gili-yankovitch/joyfon/images/hero-joyfon.png

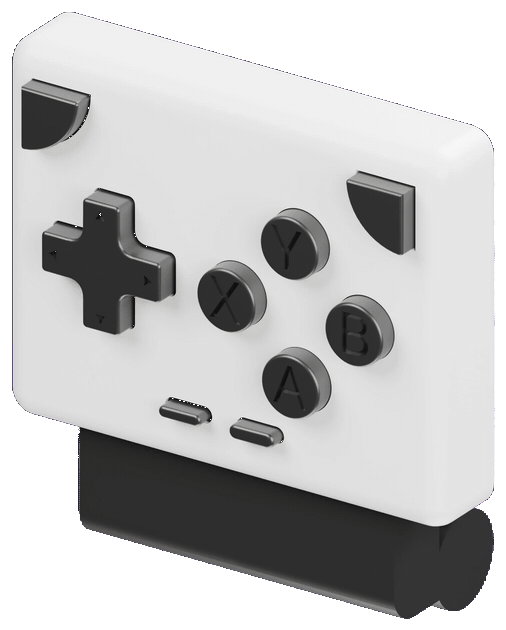
images/hero-joyfon.png
