gili-yankovitch/joyfon/images/assembly/inventory-labeled-preview.jpg

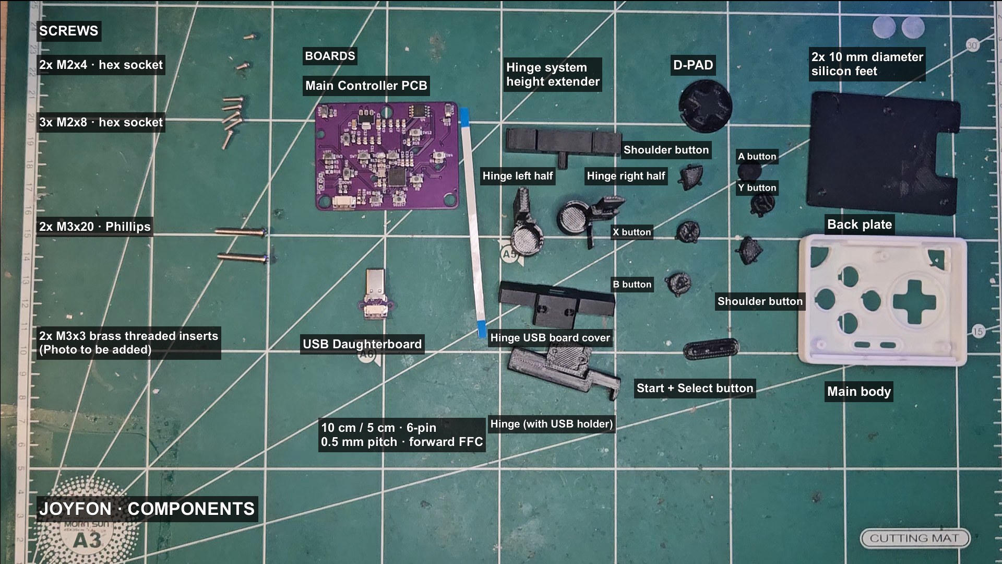
images/assembly/inventory-labeled-preview.jpg
