gili-yankovitch/joyfon/stl/PhoneControllerCaseV0.3 - ControllerBody.stl

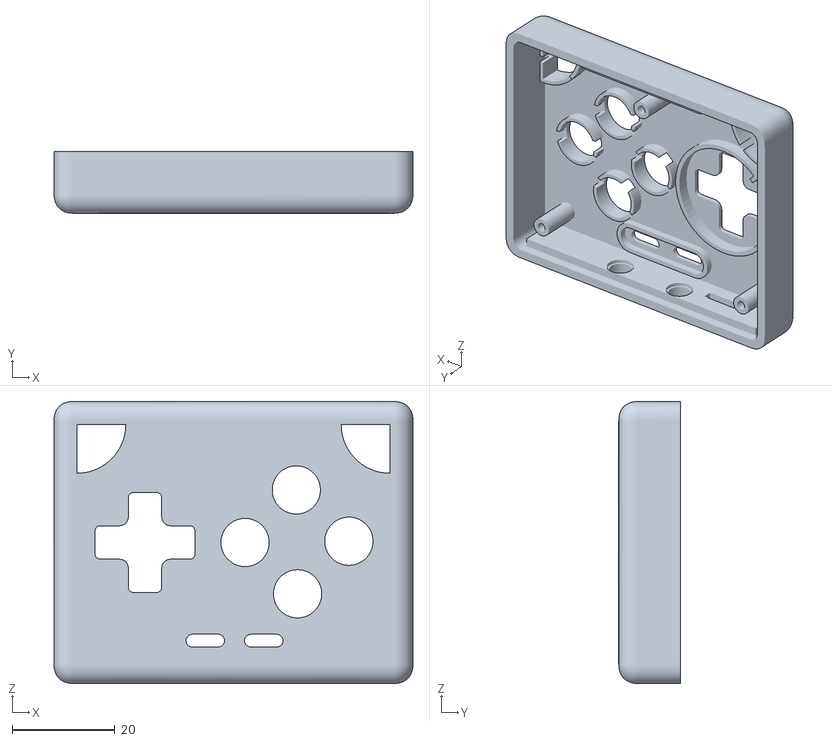
[picture p8: CAD file, 2026-10-31]
stl/PhoneControllerCaseV0.3 - ControllerBody.stl
70.0 x 12.0 x 55.0
