gili-yankovitch/joyfon/stl/PhoneControllerCaseV0.3 - BtnY.stl

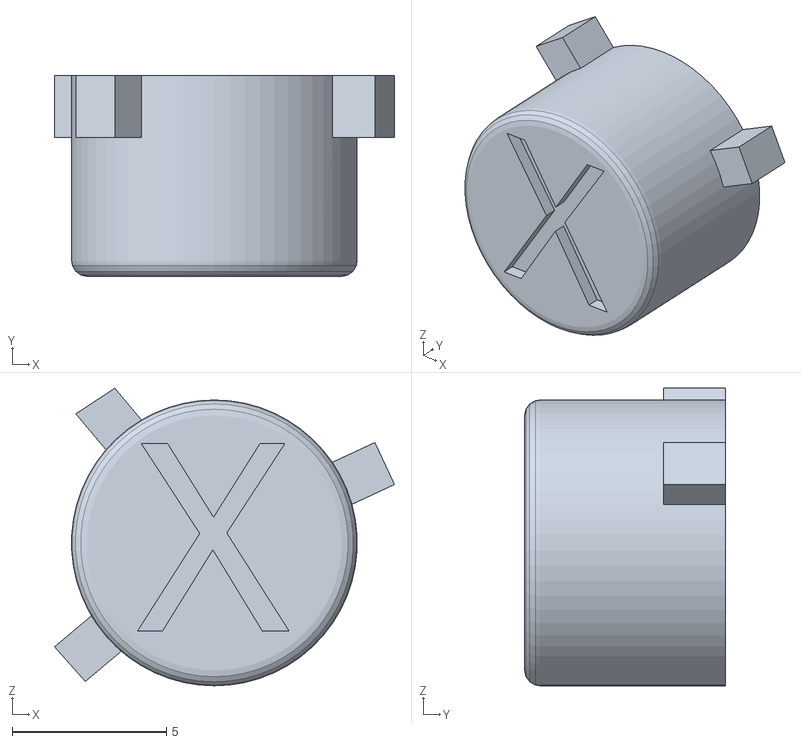
[picture p9: CAD file, 2026-10-31]
stl/PhoneControllerCaseV0.3 - BtnY.stl
11.0 x 6.50 x 9.63
