gili-yankovitch/joyfon/stl/PhoneControllerCaseV0.3 - BtnSL.stl

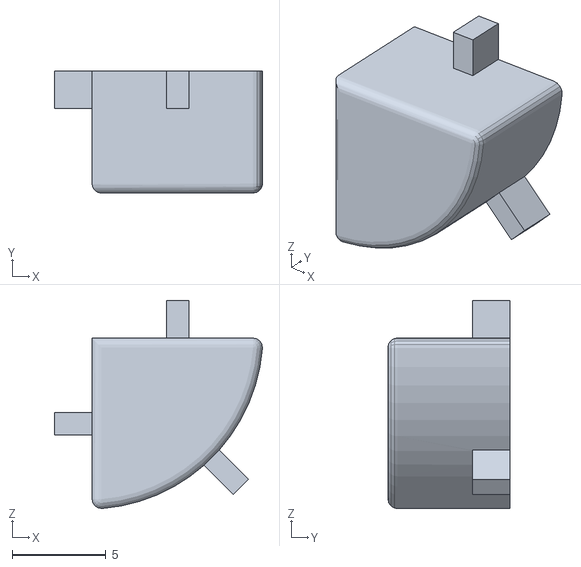
[picture p10: CAD file, 2026-10-31]
stl/PhoneControllerCaseV0.3 - BtnSL.stl
11.1 x 6.50 x 11.1
