gili-yankovitch/joyfon/stl/PhoneControllerCaseV0.3 - BtnX.stl

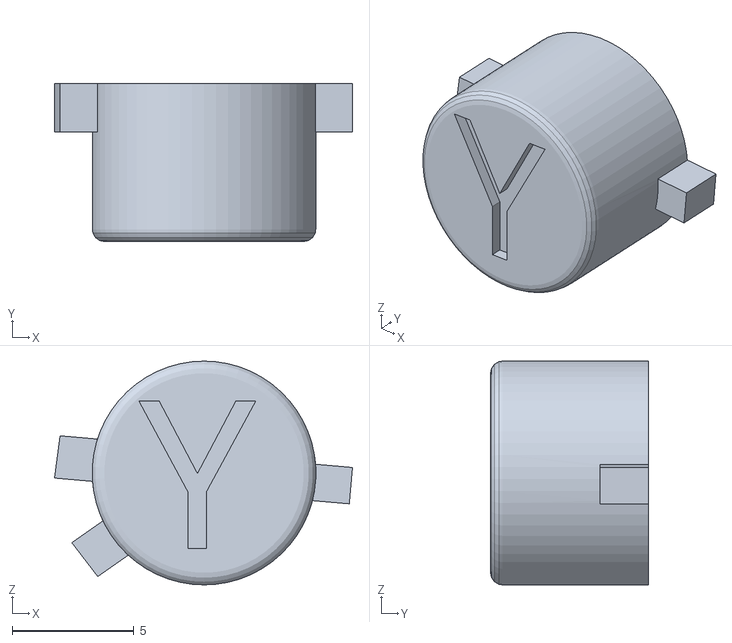
[picture p11: CAD file, 2026-10-31]
stl/PhoneControllerCaseV0.3 - BtnX.stl
12.3 x 6.50 x 9.20
