gili-yankovitch/joyfon/stl/PhoneControllerCaseV0.3 - BackPlate.stl

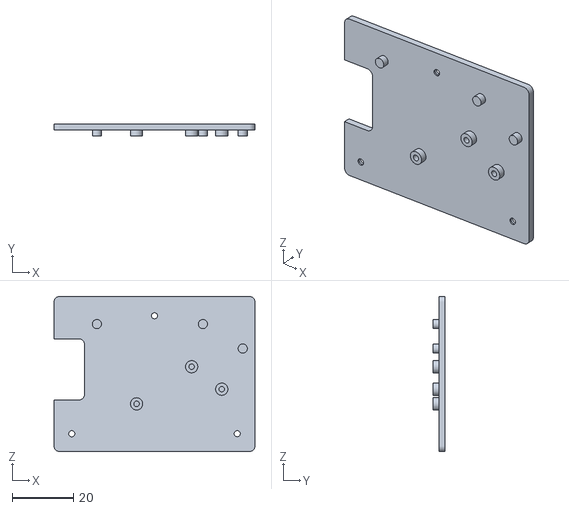
[picture p12: CAD file, 2026-10-31]
stl/PhoneControllerCaseV0.3 - BackPlate.stl
65.6 x 4.00 x 50.6
