gili-yankovitch/joyfon/stl/PhoneControllerCaseV0.3 - HingeHousingPart1-Ext.stl

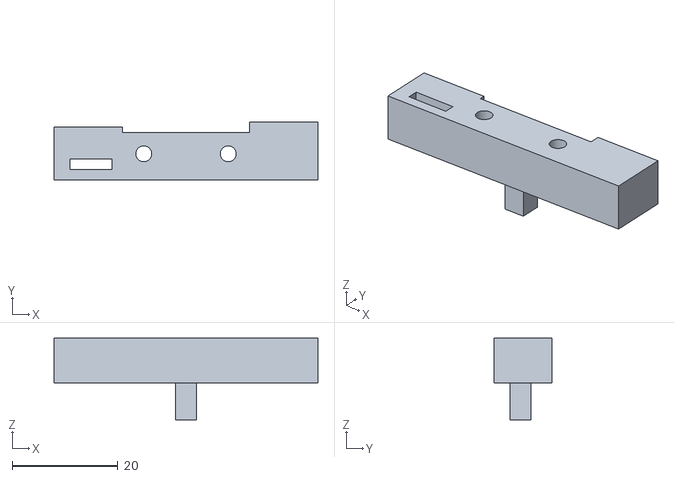
[picture p13: CAD file, 2026-10-31]
stl/PhoneControllerCaseV0.3 - HingeHousingPart1-Ext.stl
50.0 x 10.9 x 15.5
