gili-yankovitch/joyfon/stl/PhoneControllerCaseV0.3 - BtnB.stl

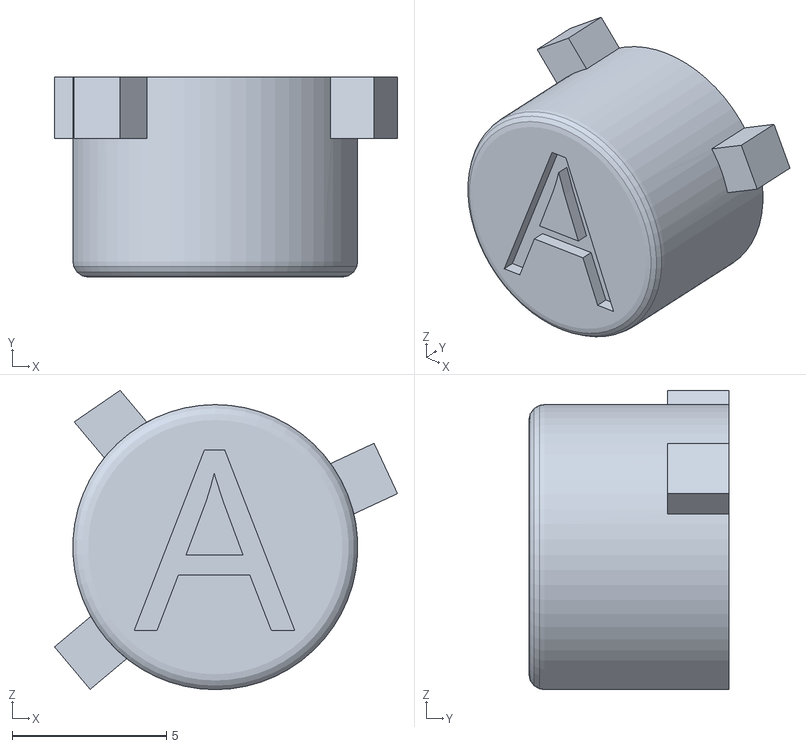
[picture p14: CAD file, 2026-10-31]
stl/PhoneControllerCaseV0.3 - BtnB.stl
11.1 x 6.50 x 9.71
