gili-yankovitch/joyfon/stl/PhoneControllerCaseV0.3 - Hinge USB2.stl

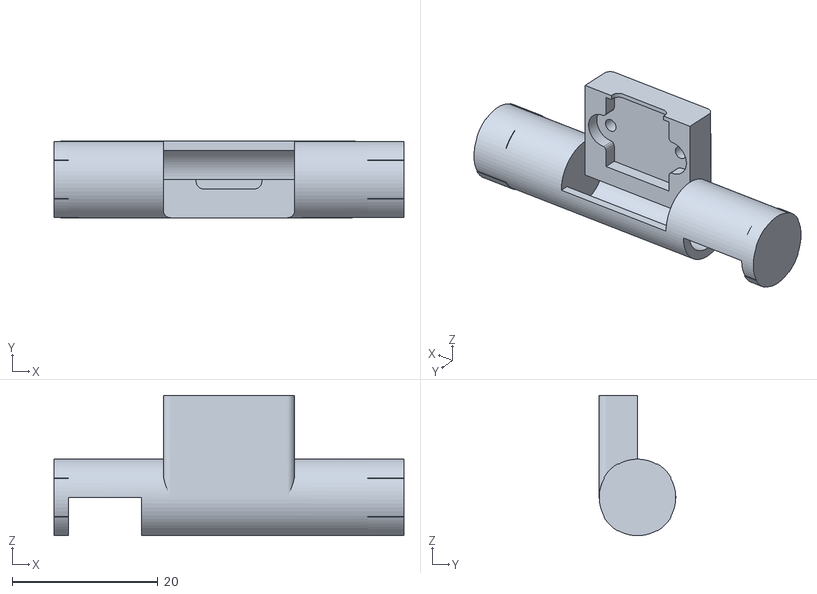
[picture p15: CAD file, 2026-10-31]
stl/PhoneControllerCaseV0.3 - Hinge USB2.stl
48.0 x 10.5 x 19.2
