gili-yankovitch/joyfon/stl/PhoneControllerCaseV0.3 - USB2 Cover.stl

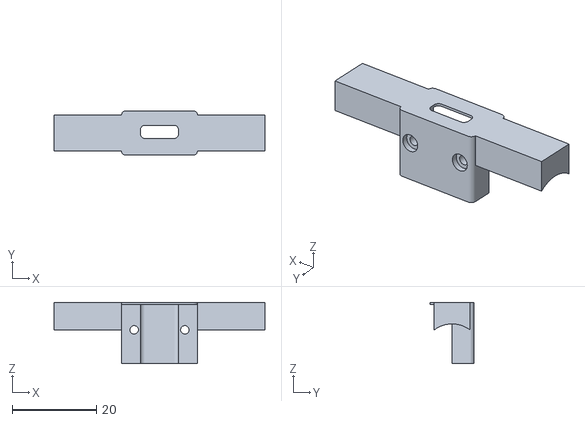
[picture p16: CAD file, 2026-10-31]
stl/PhoneControllerCaseV0.3 - USB2 Cover.stl
50.0 x 10.5 x 14.5
