gili-yankovitch/joyfon/stl/PhoneControllerCaseV0.3 - StartSelectBtns.stl

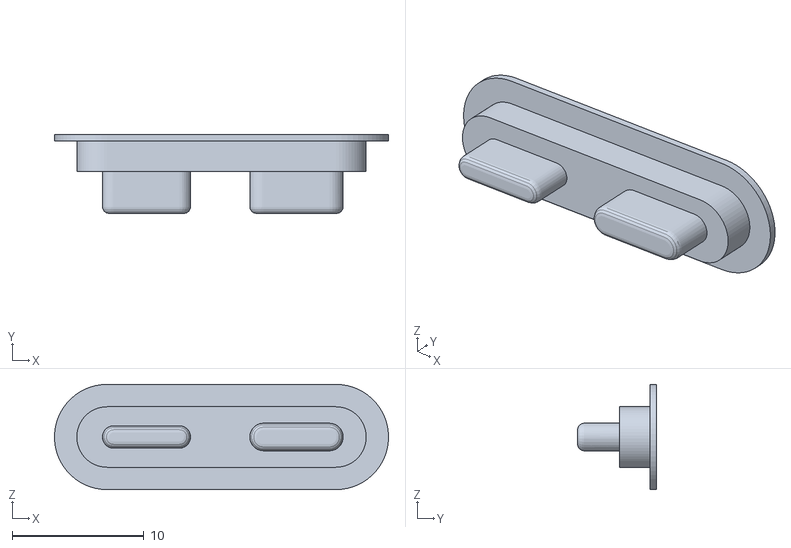
[picture p17: CAD file, 2026-10-31]
stl/PhoneControllerCaseV0.3 - StartSelectBtns.stl
25.4 x 6.00 x 8.00
