gili-yankovitch/joyfon/stl/PhoneControllerCaseV0.3 - HingeHousingPart1.stl

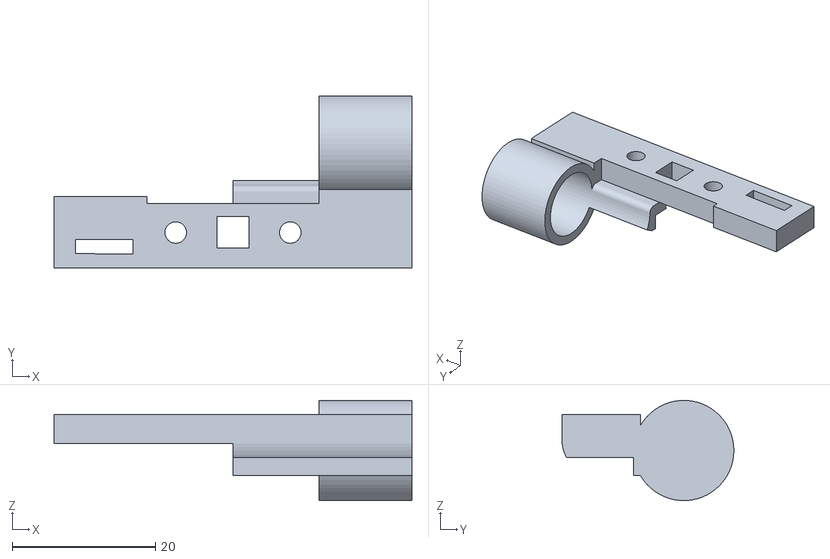
[picture p18: CAD file, 2026-10-31]
stl/PhoneControllerCaseV0.3 - HingeHousingPart1.stl
50.0 x 24.0 x 14.0
