gili-yankovitch/joyfon/stl/PhoneControllerCaseV0.3 - USB2.stl

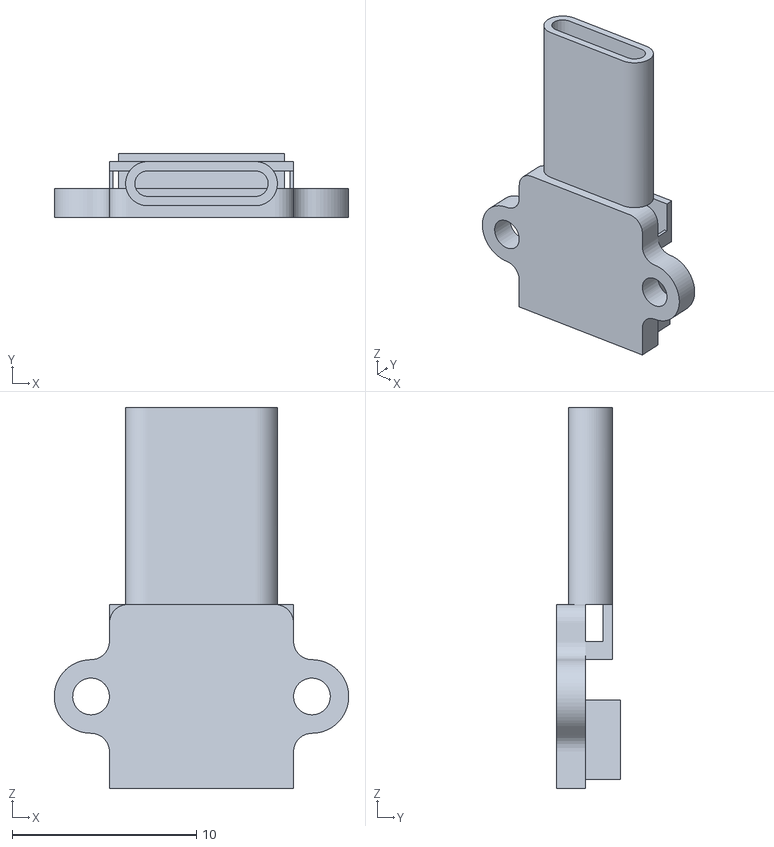
[picture p19: CAD file, 2026-10-31]
stl/PhoneControllerCaseV0.3 - USB2.stl
16.0 x 3.50 x 20.7
