gili-yankovitch/joyfon/stl/PhoneControllerCaseV0.3 - HingeHousingPart2.stl

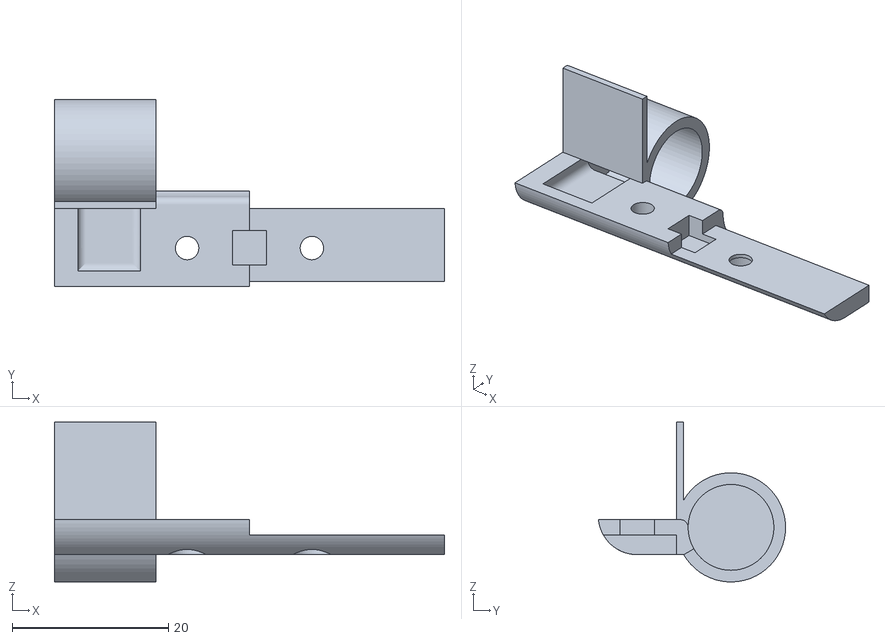
[picture p20: CAD file, 2026-10-31]
stl/PhoneControllerCaseV0.3 - HingeHousingPart2.stl
50.0 x 24.0 x 20.5
