gili-yankovitch/joyfon/stl/PhoneControllerCaseV0.3 - DPad.stl

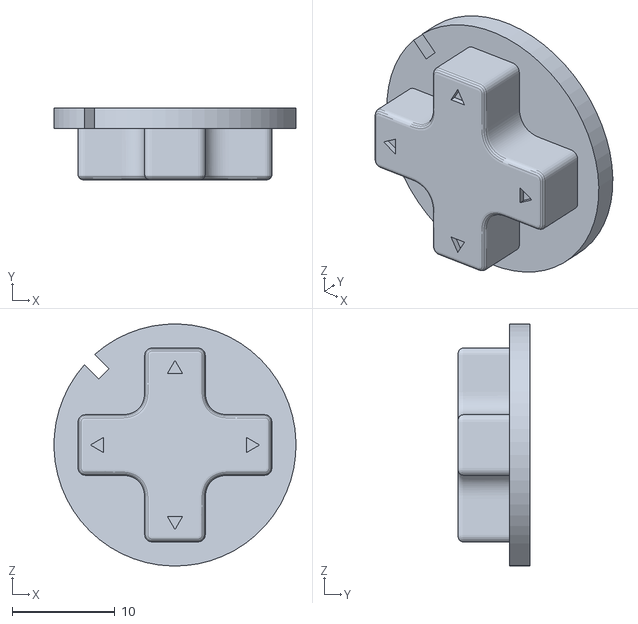
[picture p21: CAD file, 2026-10-31]
stl/PhoneControllerCaseV0.3 - DPad.stl
23.6 x 7.00 x 23.6
