gili-yankovitch/joyfon/stl/PhoneControllerCaseV0.3 - BtnA.stl

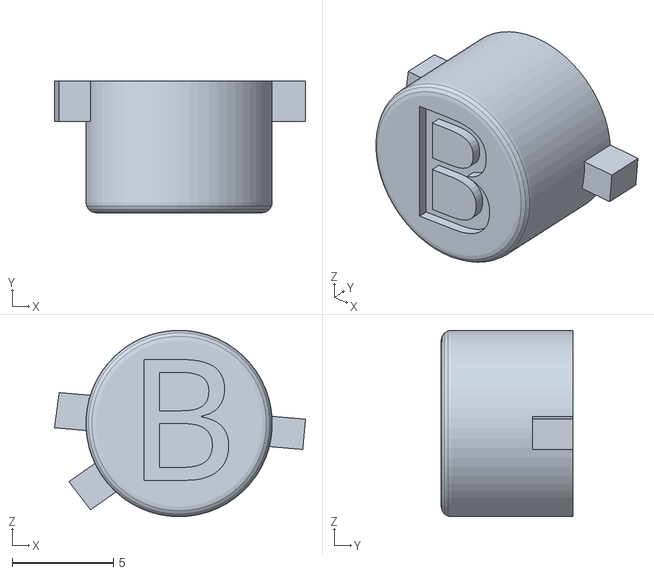
[picture p22: CAD file, 2026-10-31]
stl/PhoneControllerCaseV0.3 - BtnA.stl
12.4 x 6.50 x 9.20
