gili-yankovitch/joyfon/(list of files, cad)

Other CAD files:
stl/PhoneControllerCaseV0.3 - BtnSR.stl
