gili-yankovitch/joyfon/assembly.html

JOYFON ⚡ Flash Source ↗ (https://github.com/gili-yankovitch/joyfon)

Build your JoyFon · 12 steps

# Assembly guide

From the USB Daughterboard to the final button check. Follow the photos in order, with the correct fasteners and a check at every stage.

Start assembling ↓

Before you begin

## Parts on the table.

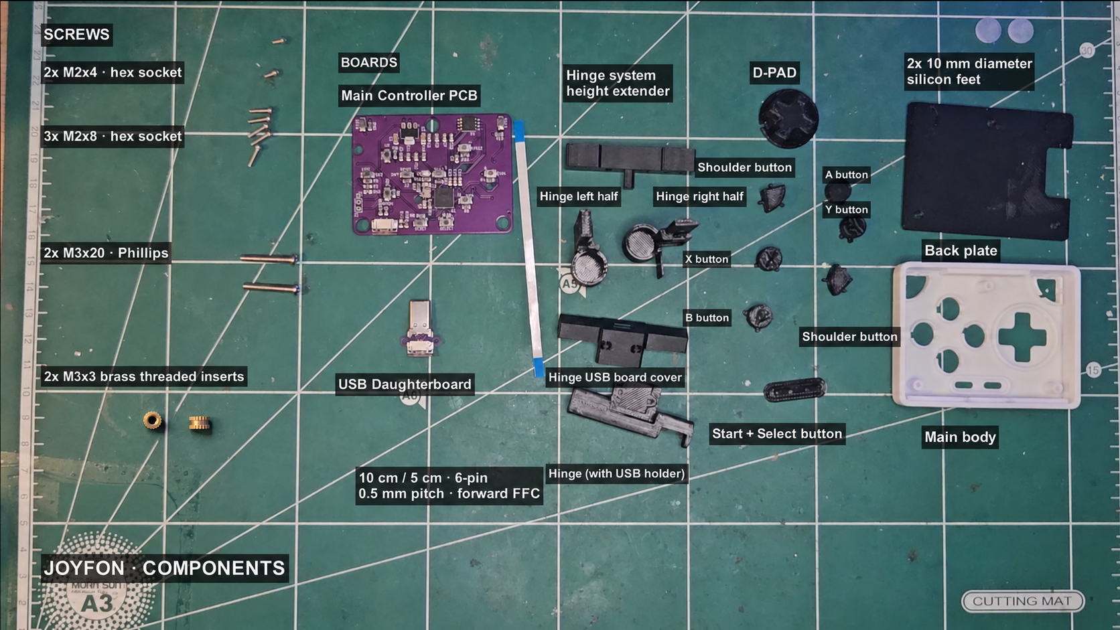
[picture p23: images/assembly/inventory-with-inserts.png]
JoyFon components laid out for assembly. Two M3x3 brass threaded inserts are shown at the bottom left, using top and side views of the same part.


JoyFon components laid out for assembly. Two M3x3 brass threaded inserts are shown at the bottom left, using top and side views of the same part.

- Screws: 2x M2x4, 3x M2x8, 2x M3x20
- 2x M3x3 brass threaded inserts
- Boards: Main Controller PCB; USB Daughterboard
- 10 cm / 5 cm, 6-pin, 0.5 mm pitch forward FFC ribbon cable
- Hinge itself (with USB holder); hinge system height extender; hinge left half; hinge right half; hinge USB board cover
- D-PAD; shoulder button; A; Y; X; B; shoulder button; Start + Select button
- 2x 10 mm-diameter silicon feet; back plate; main body

Fasteners and their uses
Quantity | Hardware | Driver | Use
2 | M2x4 | hex socket | Main Controller PCB to back plate
3 | M2x8 | hex socket | Back plate to main controller body
2 | M3x20 | Phillips | Hinge system to main controller body
2 | M3x3 brass threaded inserts | Soldering iron | Hinge mounting points in the main body

Identify the Main Controller PCB and the USB Daughterboard. The USB Daughterboard carries the USB-C male plug and an FFC ribbon-cable connector; the two boards connect through the ribbon cable.

Prepare the hinge itself (the hinge with USB holder part), hinge system height extender, hinge left half, hinge right half, hinge USB board cover, main body and back plate.

Lay out the D-PAD, two identical shoulder buttons, A, Y, X and B buttons, and the symmetric Start + Select button piece. Prepare two 10 mm-diameter silicon feet.

Use a matching hex driver for the M2 screws and a Phillips screwdriver for the M3x20 screws. Have a soldering iron ready for the two M3x3 brass threaded inserts. Keep the phone disconnected during assembly.

Step 01 / 12

## Connect the ribbon to the USB Daughterboard

Insert the 6-pin, 0.5 mm-pitch forward FFC ribbon into the connector on the USB Daughterboard, matching the orientation in the close-up. Seat it squarely.

Fit the board with its USB-C male plug aligned to its opening in the hinge with USB holder part. Fold the ribbon smoothly back and to the right to allow it to sit gently on the hinge's floor.

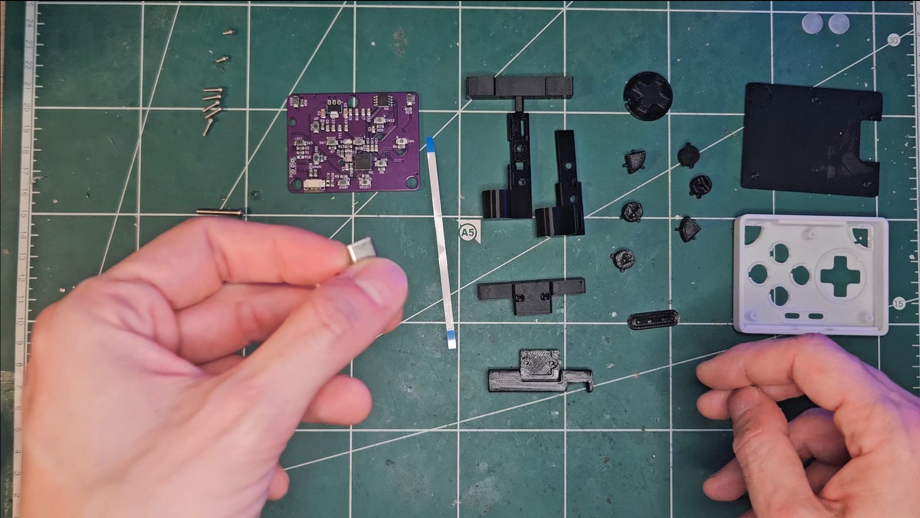
[picture p24: images/assembly/01-connector-ribbon-01.jpg]
USB Daughterboard: align the USB-C male plug and the ribbon-cable connector.


USB Daughterboard: align the USB-C male plug and the ribbon-cable connector.

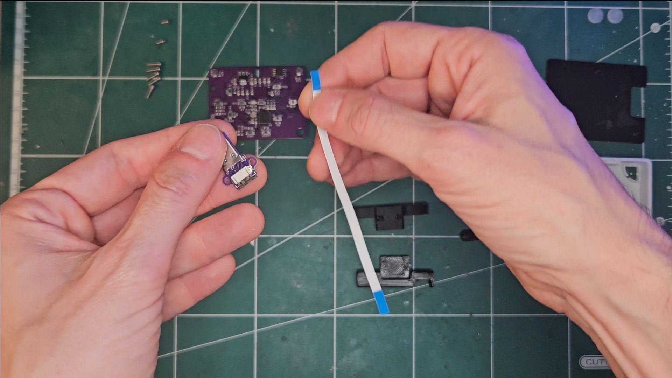
[picture p25: images/assembly/01-connector-ribbon-02.jpg]
Insert the 6-pin, 0.5 mm-pitch forward FFC ribbon squarely into the USB Daughterboard.


Insert the 6-pin, 0.5 mm-pitch forward FFC ribbon squarely into the USB Daughterboard.

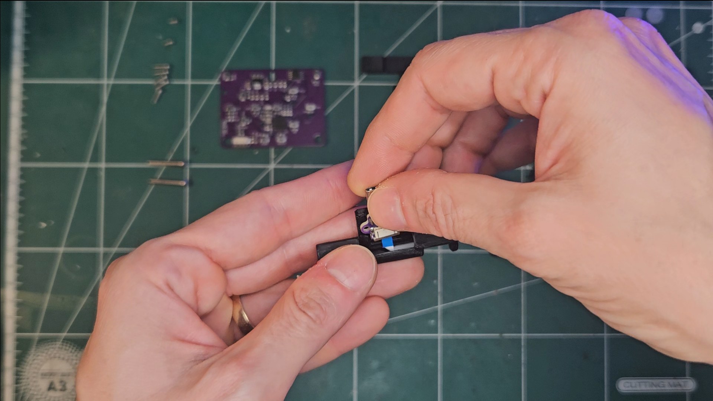
[picture p26: images/assembly/01-connector-ribbon-03.jpg]
Fold the ribbon smoothly back and to the right so it sits gently on the hinge's floor, and fit the USB Daughterboard into the hinge part recess.


Fold the ribbon smoothly back and to the right so it sits gently on the hinge's floor, and fit the USB Daughterboard into the hinge part recess.

CHECK

The ribbon is seated squarely, folded smoothly back and to the right, and rests on the hinge's floor without twisting.

Back to top ↑

Step 02 / 12

## Fit the hinge USB board cover

Fit the hinge USB board cover while keeping the ribbon clear of the mating surfaces. Check both seating points shown in the photos.

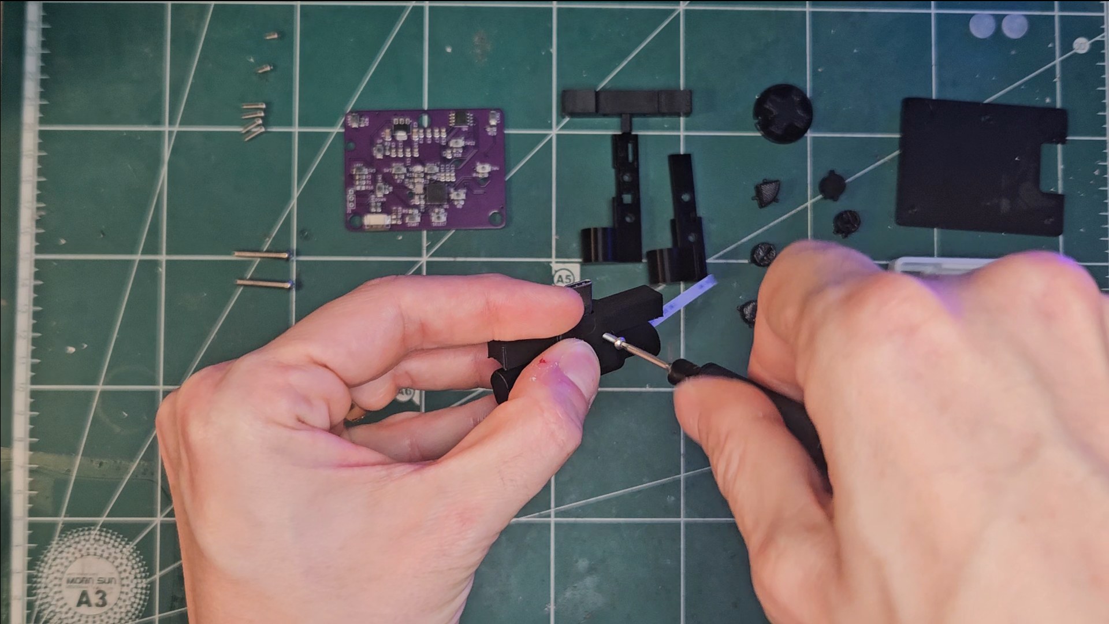
[picture p27: images/assembly/02-enclosure-screws-01.jpg]
Seat the hinge USB board cover over the USB Daughterboard, with the ribbon clear.


Seat the hinge USB board cover over the USB Daughterboard, with the ribbon clear.

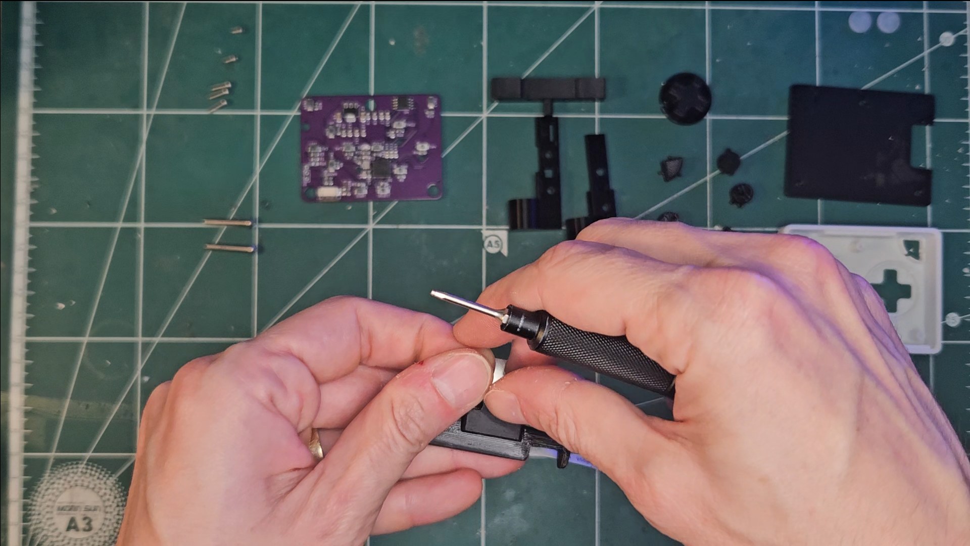
[picture p28: images/assembly/02-enclosure-screws-02.jpg]
Check the other seating point while keeping the USB-C male plug aligned.


Check the other seating point while keeping the USB-C male plug aligned.

CHECK

The USB Daughterboard and hinge USB board cover are seated, the USB-C male plug is aligned, and the ribbon is not trapped.

Back to top ↑

Step 03 / 12

## Route the ribbon and assemble the hinge system

Roll the cable excess twice and fit the rolled cable inside the open hollow of the hinge itself (the hinge with USB holder part).

Then, route the ribbon cable through the back opening of the hinge. Bring the separate hinge right half into position, as shown in the second photo. Slide the ribbon cable through the hinge right half slit on its circular cavity.

Slide the ribbon cable through the slit on the right side of the hinge left half's flat part. Slide the hinge itself into the left round cavity of the left hinge half, bringing the two hinge halves together.

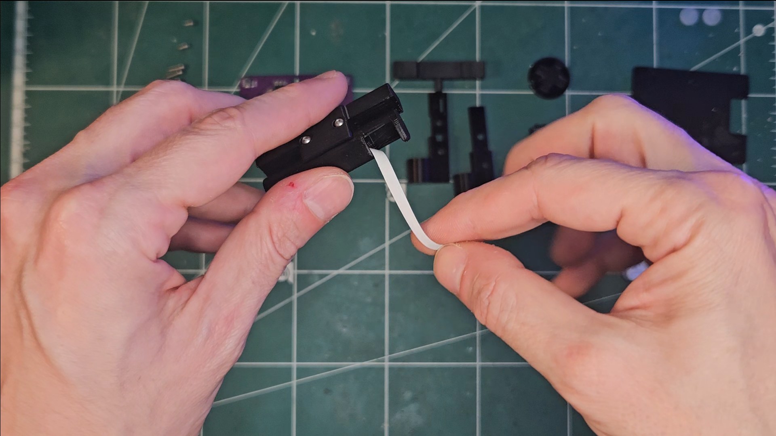
[picture p29: images/assembly/03-sliding-clamp-01.jpg]
The hinge: roll the excess cable twice and fit it into the hinge's own open hollow, not into a hinge half.


The hinge: roll the excess cable twice and fit it into the hinge's own open hollow, not into a hinge half.

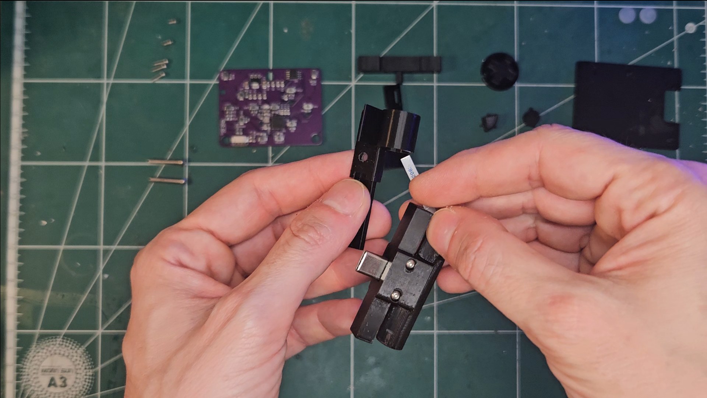
[picture p30: images/assembly/03-sliding-clamp-02.jpg]
The hinge right half: bring this separate half around the hinge, routing the ribbon through the opening.


The hinge right half: bring this separate half around the hinge, routing the ribbon through the opening.

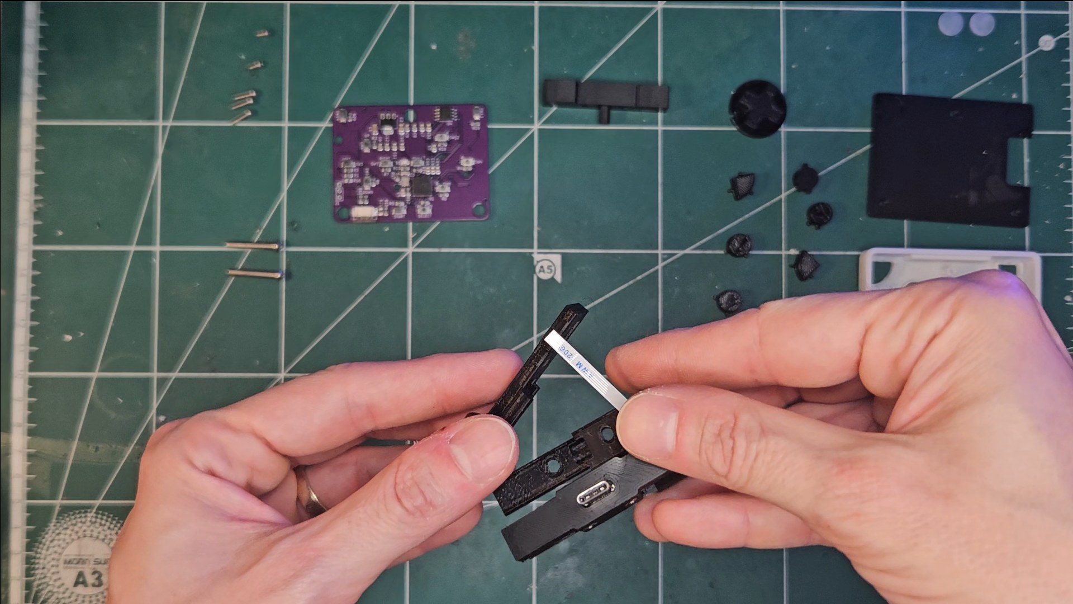
[picture p31: images/assembly/03-sliding-clamp-03.jpg]
The hinge left half: guide the ribbon through its right-side slit, then slide the hinge itself into the left round cavity.


The hinge left half: guide the ribbon through its right-side slit, then slide the hinge itself into the left round cavity.

Use the hinge system height extender and slide its pin down the hollow of the hinge halves. Align the ribbon with the right-side slit while bringing the hinge and the two halves together.

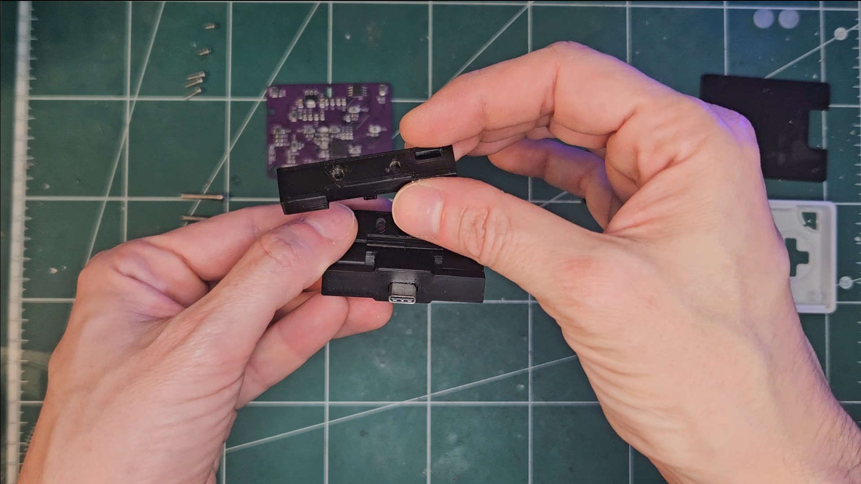
[picture p32: images/assembly/03-sliding-clamp-04.jpg]
Fit the hinge system height extender through the two hinge halves while keeping the ribbon clear of the slit edges.


Fit the hinge system height extender through the two hinge halves while keeping the ribbon clear of the slit edges.

CHECK

Check that the cable is not pinched by the hinge itself or the hinge housings. Keep the ribbon aligned with the right-side slit as the parts come together.

Back to top ↑

Step 04 / 12

## Prepare the two M3x20 hinge-system screws

Use the two M3x20 Phillips screws at the hinge-system mounting points shown.

Do not fully insert or tighten them yet. Advance each screw only until its far end is flush with the hinge top. Final tightening happens after the threaded inserts are installed in the main controller body.

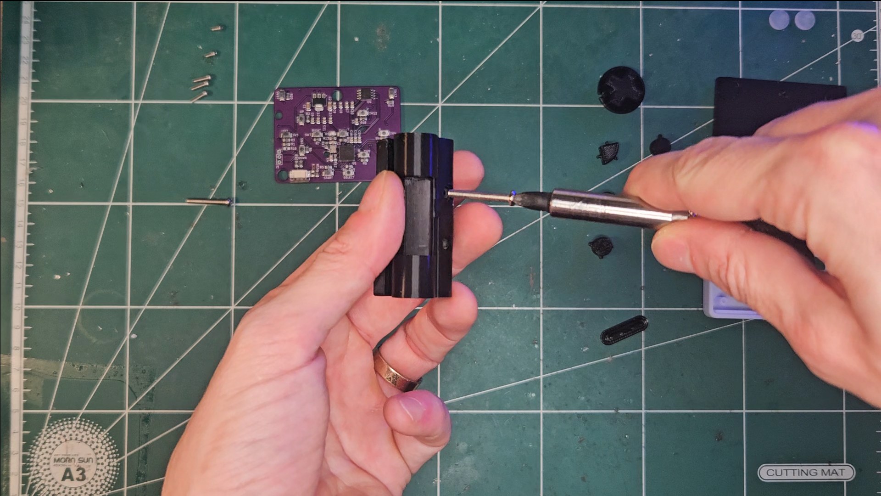
[picture p33: images/assembly/04-clamp-screws-01.jpg]
Start the first M3x20 Phillips screw; leave its far end flush with the hinge top.


Start the first M3x20 Phillips screw; leave its far end flush with the hinge top.

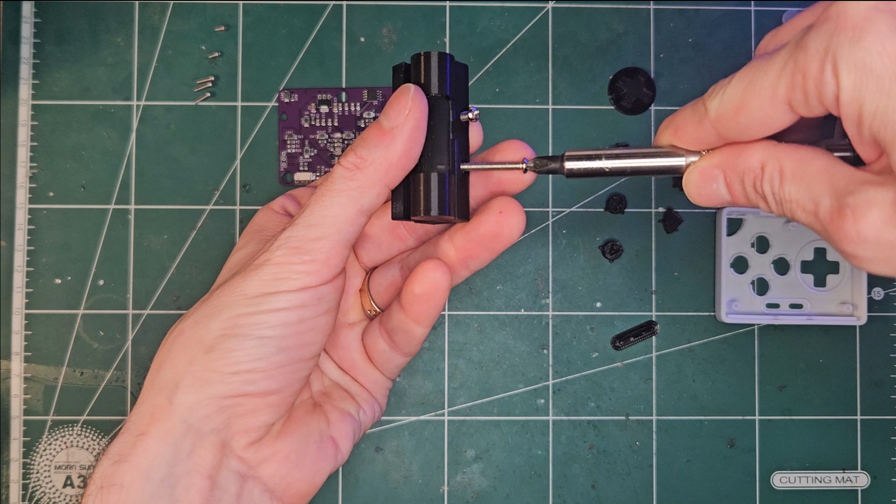
[picture p34: images/assembly/04-clamp-screws-02.jpg]
Set the second M3x20 Phillips screw to the same flush position. Do not fully tighten yet.


Set the second M3x20 Phillips screw to the same flush position. Do not fully tighten yet.

CHECK

Both M3x20 screw tips are flush with the hinge top. Neither screw is fully tightened yet.

Back to top ↑

Step 05 / 12

## Secure the Main Controller PCB to the back plate

Align the Main Controller PCB with the back plate and its mounting holes.

Use the two M2x4 hex-socket screws to hold the main PCB to the back plate. Fit the first screw, then the second, while keeping the PCB seated at both mounting points.

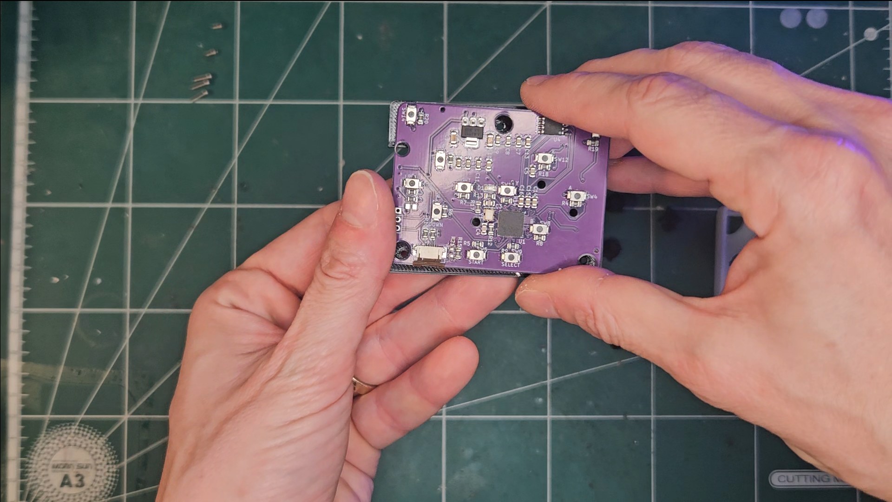
[picture p35: images/assembly/05-pcb-backplate-01.jpg]
Align the Main Controller PCB and the back plate at their mounting holes.


Align the Main Controller PCB and the back plate at their mounting holes.

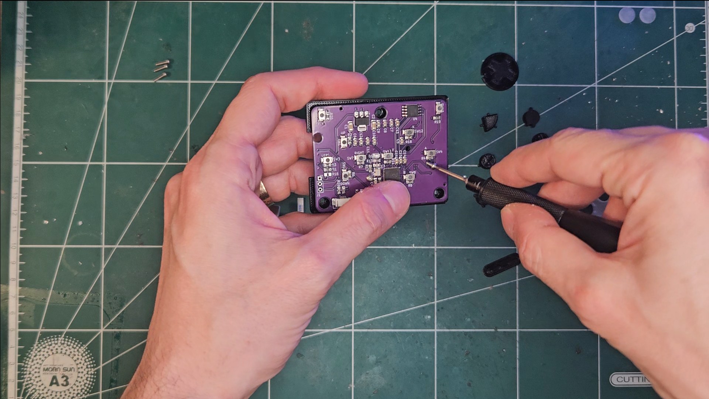
[picture p36: images/assembly/05-pcb-backplate-02.jpg]
Fit the first M2x4 hex-socket screw holding the main PCB to the back plate.


Fit the first M2x4 hex-socket screw holding the main PCB to the back plate.

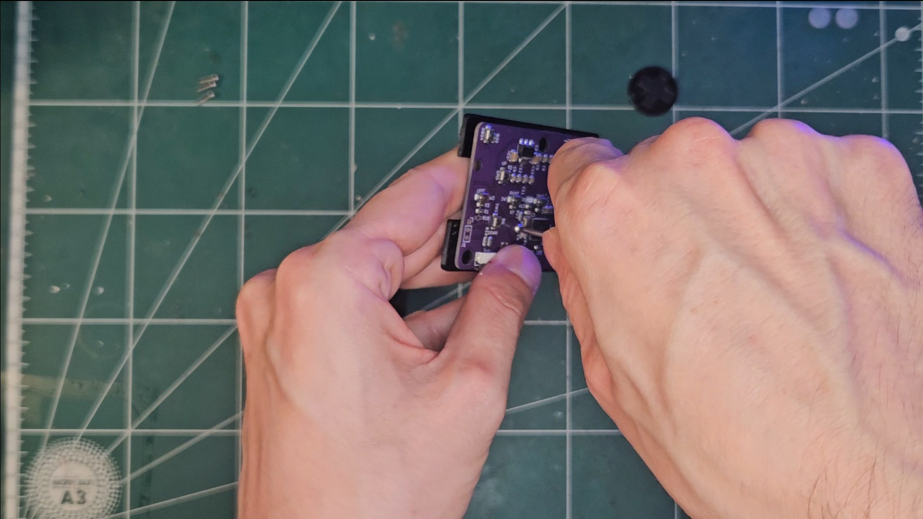
[picture p37: images/assembly/05-pcb-backplate-03.jpg]
Fit the second M2x4 hex-socket screw while keeping the PCB seated.


Fit the second M2x4 hex-socket screw while keeping the PCB seated.

CHECK

Both M2x4 hex-socket screws are fitted and the PCB lies flat against its mounting points.

Back to top ↑

Step 06 / 12

## Install the two M3x3 brass threaded inserts

Identify the two M3x3 brass threaded inserts and the two holes in the bottom of the controller main body. The two holes are indicated by arrows in the second photo.

Place the inserts upright in the holes. Use the soldering iron to warm and gently seat the inserts, then allow the body to cool.

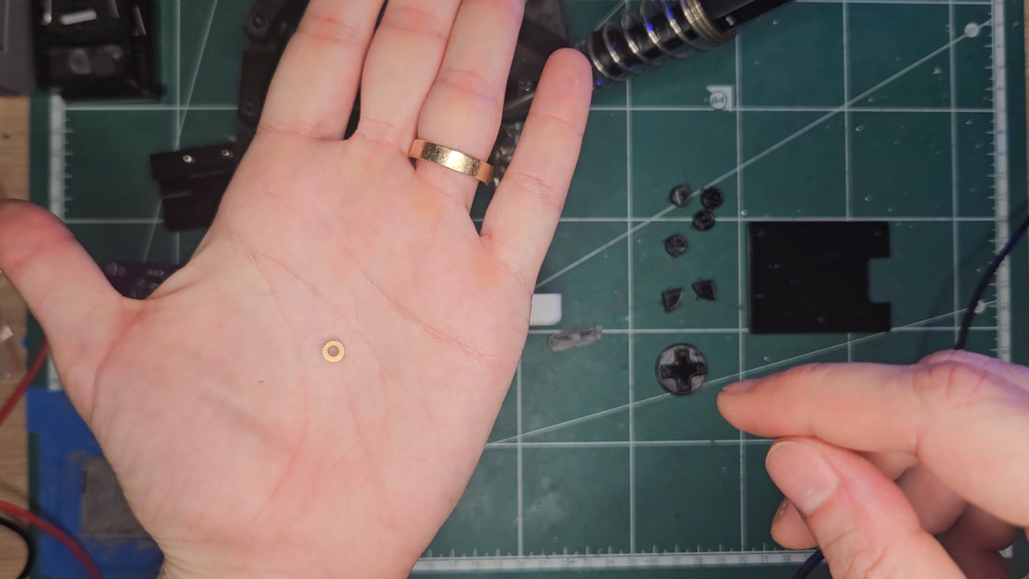
[picture p38: images/assembly/06-inserts-visible-0259.jpg]
Identify the M3x3 brass threaded inserts before installation.


Identify the M3x3 brass threaded inserts before installation.

The arrows indicate the two holes that will house the M3x3 brass threaded inserts.

The arrows indicate the two holes that will house the M3x3 brass threaded inserts.

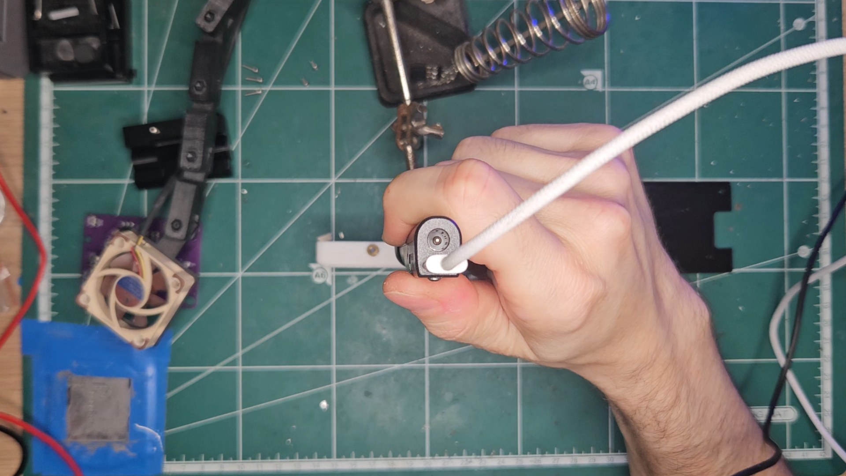
[picture p39: images/assembly/06-threaded-inserts-03.jpg]
Use the soldering iron to seat the inserts in the main controller body.


Use the soldering iron to seat the inserts in the main controller body.

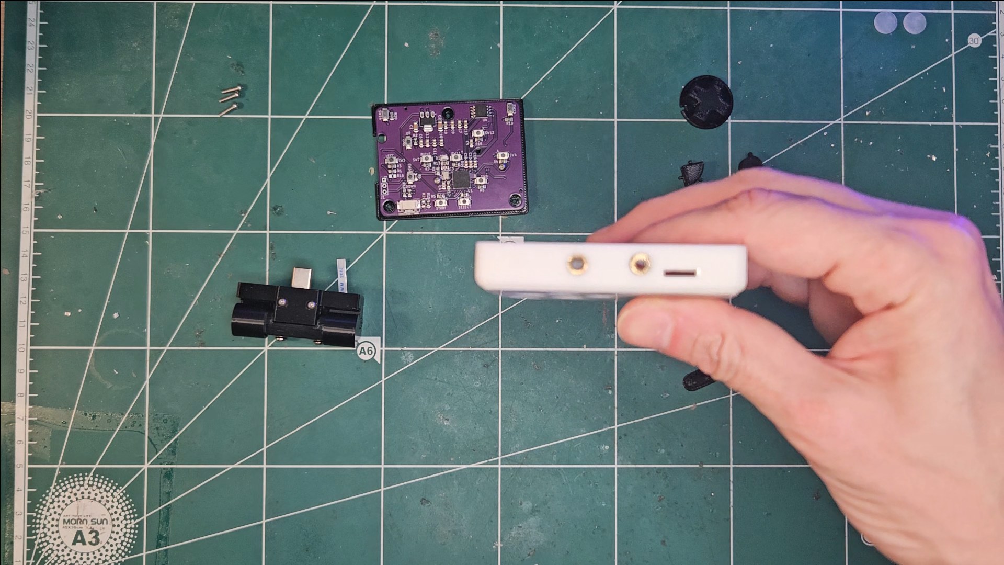
[picture p40: images/assembly/06-threaded-inserts-04.jpg]
Check that both inserts are flush with the body's bottom plane and horizontally aligned.


Check that both inserts are flush with the body's bottom plane and horizontally aligned.

CHECK

Ensure the threaded inserts are flush with the bottom plane of the controller main body and aligned on the horizontal axis.

Back to top ↑

Step 07 / 12

## Attach the hinge system to the main controller body

Insert the ribbon cable through the right-side slit in the controller main body. Bring the hinge system into position while keeping the ribbon clear of the mating surfaces.

Seat the hinge system against the main controller body. Tighten the M3x20 screws holding the hinge system: they should align with and tighten into the respective M3x3 threaded inserts embedded in the controller body.

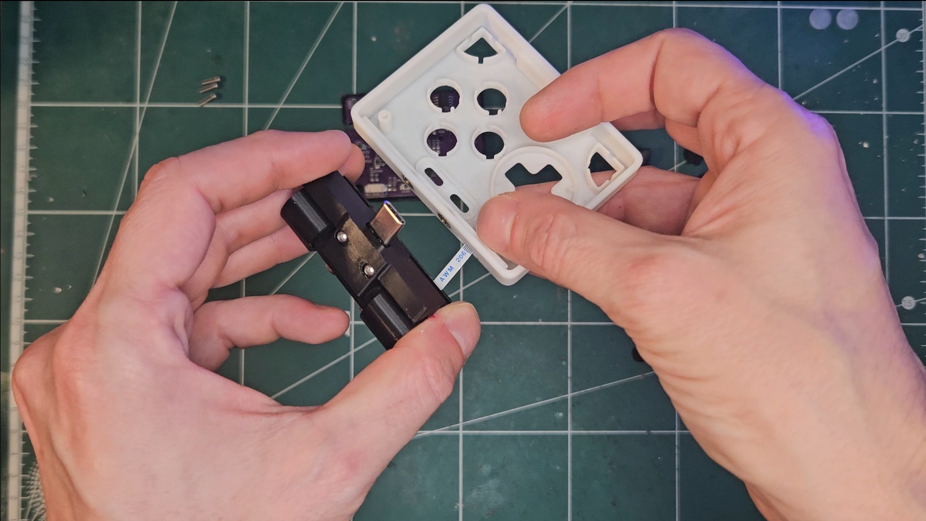
[picture p41: images/assembly/07-housing-join-01.jpg]
Insert the ribbon through the right-side slit in the main controller body.


Insert the ribbon through the right-side slit in the main controller body.

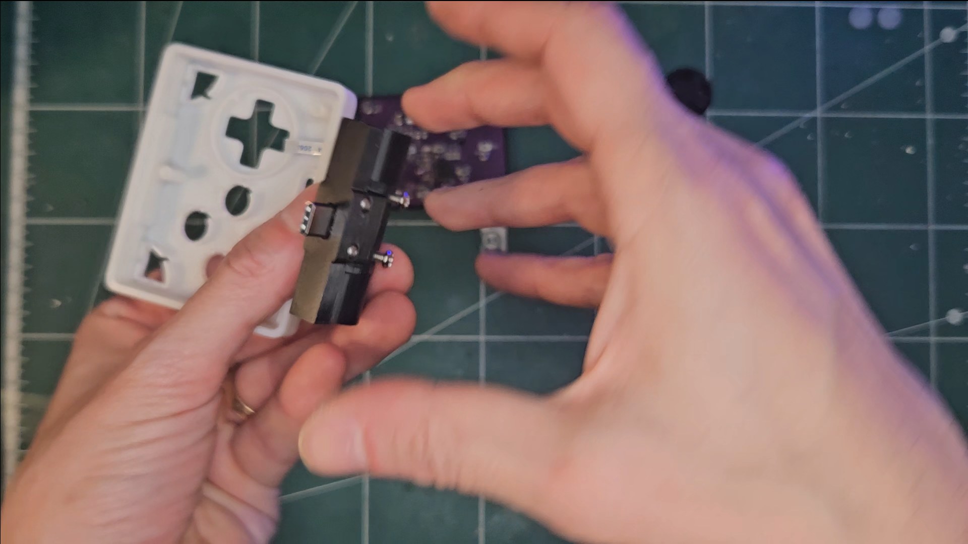
[picture p42: images/assembly/07-housing-join-02.jpg]
Bring the hinge system and main body together, without pinching the cable.


Bring the hinge system and main body together, without pinching the cable.

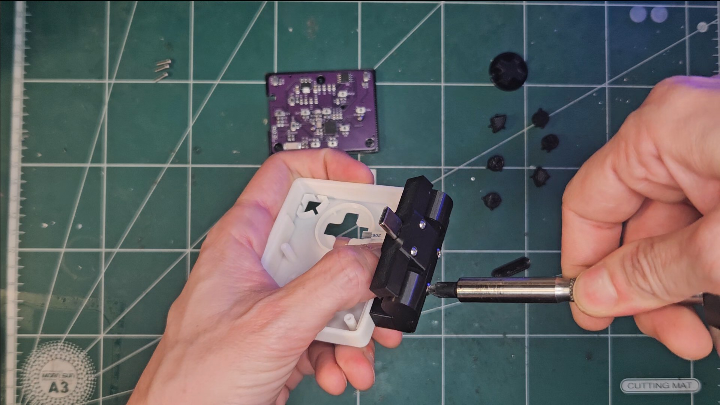
[picture p43: images/assembly/07-housing-join-03.jpg]
Now tighten both M3x20 Phillips screws into the corresponding embedded threaded inserts.


Now tighten both M3x20 Phillips screws into the corresponding embedded threaded inserts.

CHECK

Both M3x20 screws engage their respective inserts. The hinge system is seated and the ribbon is not pinched.

Back to top ↑

Step 08 / 12

## Connect the ribbon to the Main Controller PCB

Turn the free ribbon end toward the Main Controller PCB connector, matching the fold and contact orientation shown.

Insert and secure the ribbon squarely. Keep enough relaxed cable for the Main Controller PCB and back plate to fold onto the main controller body without stretching or pinching the ribbon.

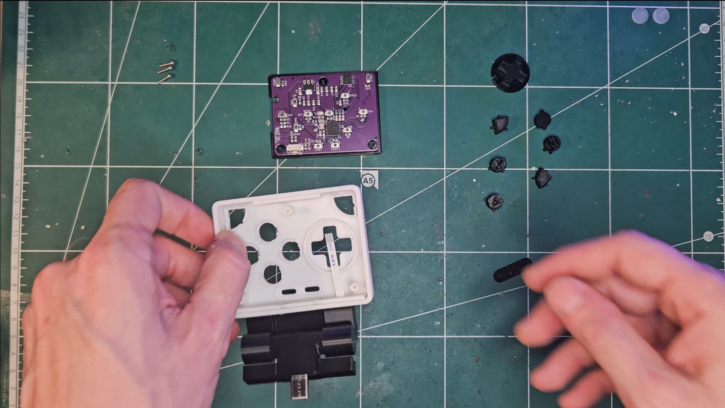
[picture p44: images/assembly/08-ribbon-pcb-01.jpg]
Turn the FFC ribbon toward the Main Controller PCB connector.


Turn the FFC ribbon toward the Main Controller PCB connector.

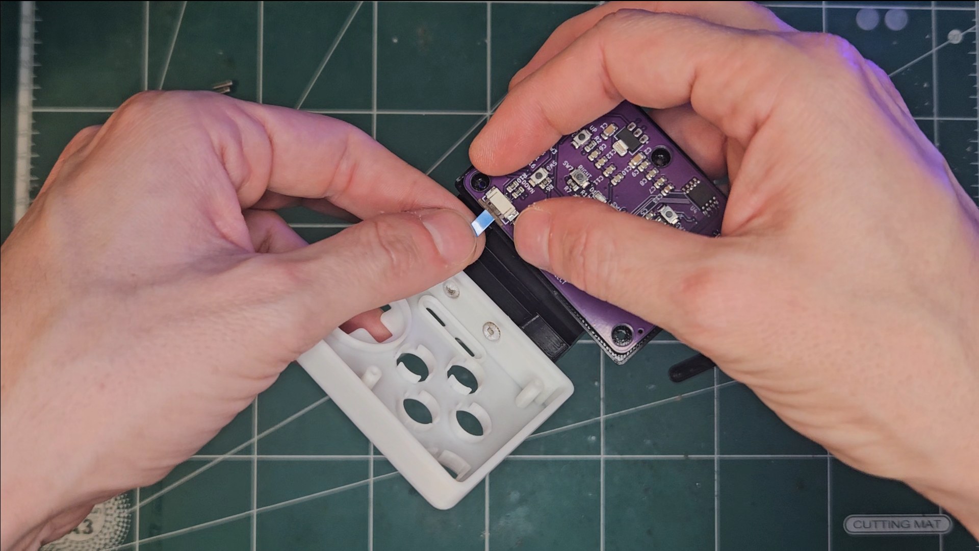
[picture p45: images/assembly/08-ribbon-pcb-02.jpg]
Insert the ribbon squarely to connect the Main Controller PCB to the USB Daughterboard.


Insert the ribbon squarely to connect the Main Controller PCB to the USB Daughterboard.

CHECK

The FFC cable connects the USB Daughterboard to the Main Controller PCB and has room to fold inside the body.

Back to top ↑

Step 09 / 12

## Fit the D-PAD, shoulder buttons and face buttons

Work from the inside perspective shown. The D-PAD goes inside the round cavity to the right; notice and match the notch that orients it.

The two shoulder buttons are identical. Fit one into each upper corner. The Start + Select button piece is symmetric and goes at the bottom.

Arrange the ABXY buttons clockwise from the inside perspective: X, Y, B, A.

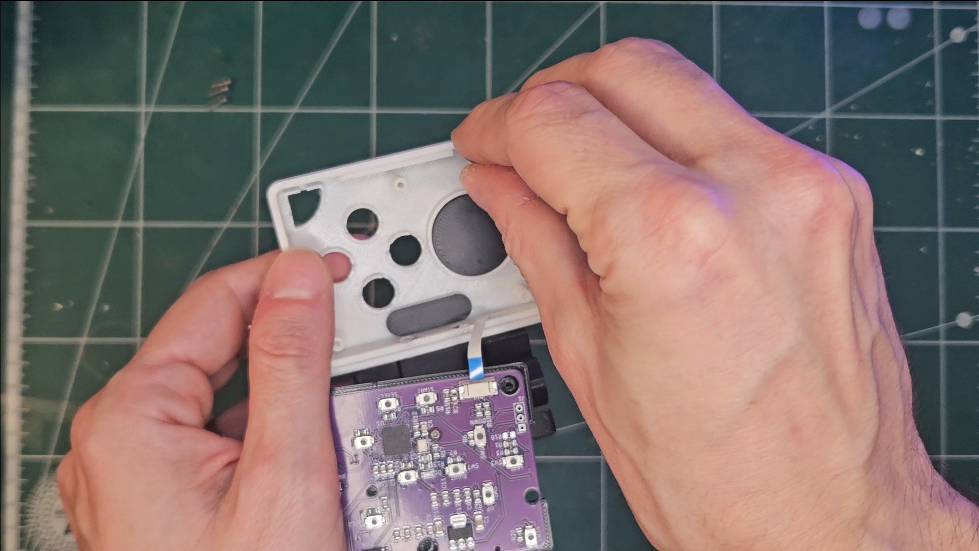
[picture p46: images/assembly/09-controls-membrane-01.jpg]
Inside view: orient the D-PAD by its notch in the right round cavity; fit the identical shoulder buttons into the upper corners.


Inside view: orient the D-PAD by its notch in the right round cavity; fit the identical shoulder buttons into the upper corners.

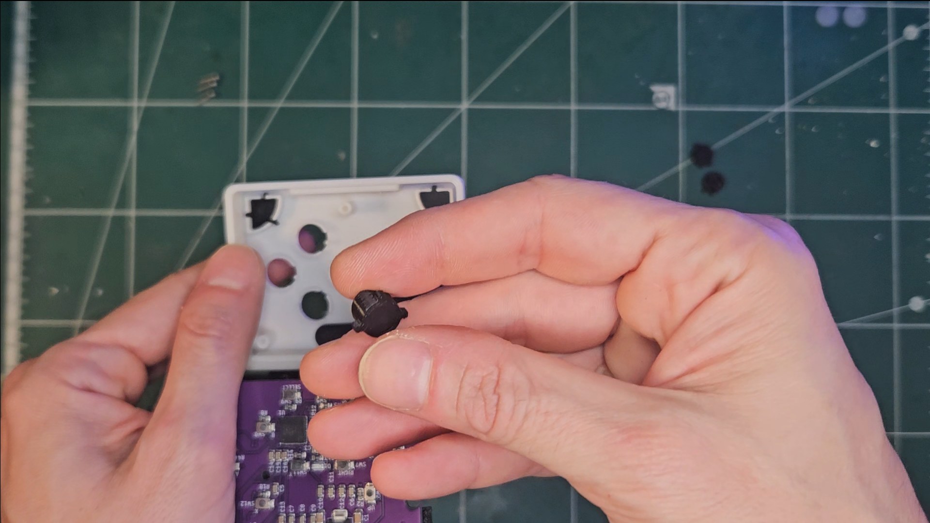
[picture p47: images/assembly/09-controls-membrane-02.jpg]
Fit the symmetric Start + Select piece at the bottom. The inside-view clockwise face-button order is X, Y, B, A.


Fit the symmetric Start + Select piece at the bottom. The inside-view clockwise face-button order is X, Y, B, A.

CHECK

The D-PAD notch is aligned, both shoulder buttons are seated, Start + Select is at the bottom, and the inside-view clockwise sequence is X-Y-B-A.

Back to top ↑

Step 10 / 12

## Fit the back plate and fasten three M2x8 screws

Fold the Main Controller PCB and back plate onto the main controller body while guiding the ribbon into the internal space.

It might be easier to fit the bottom part of the back plate first, then slide in the top.

Use the three M2x8 hex-socket screws to close the back plate to the main controller body. Keep the panel seated while fastening all three mounting points.

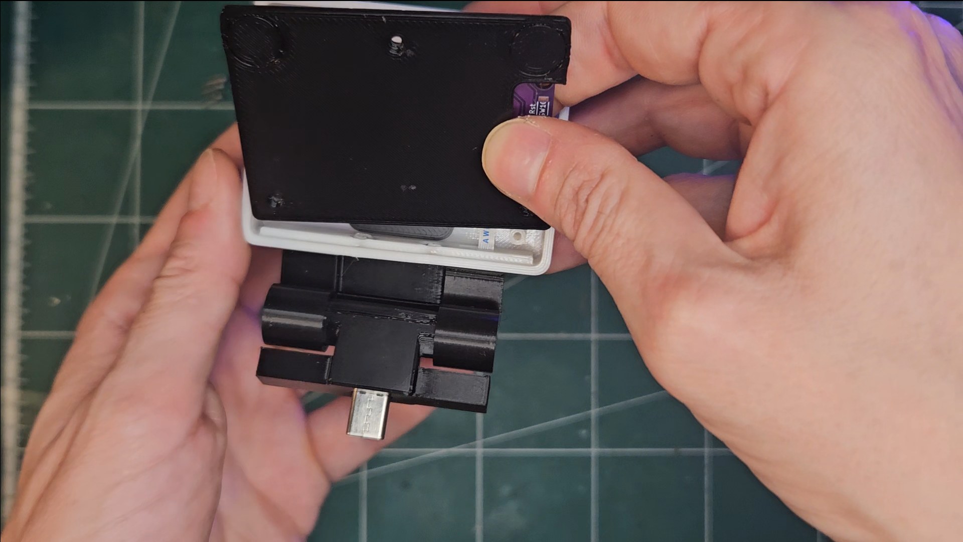
[picture p48: images/assembly/10-back-panel-screws-v2-02.jpg]
Fit the bottom of the back plate first, then slide the top into place.


Fit the bottom of the back plate first, then slide the top into place.

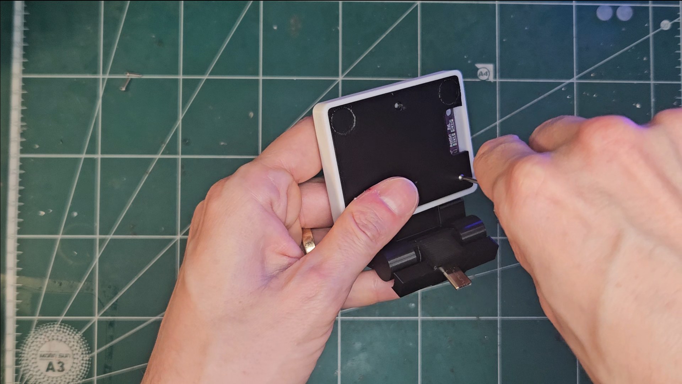
[picture p49: images/assembly/10-back-panel-screws-v2-03.jpg]
Fasten the first of the three M2x8 hex-socket back-plate screws.


Fasten the first of the three M2x8 hex-socket back-plate screws.

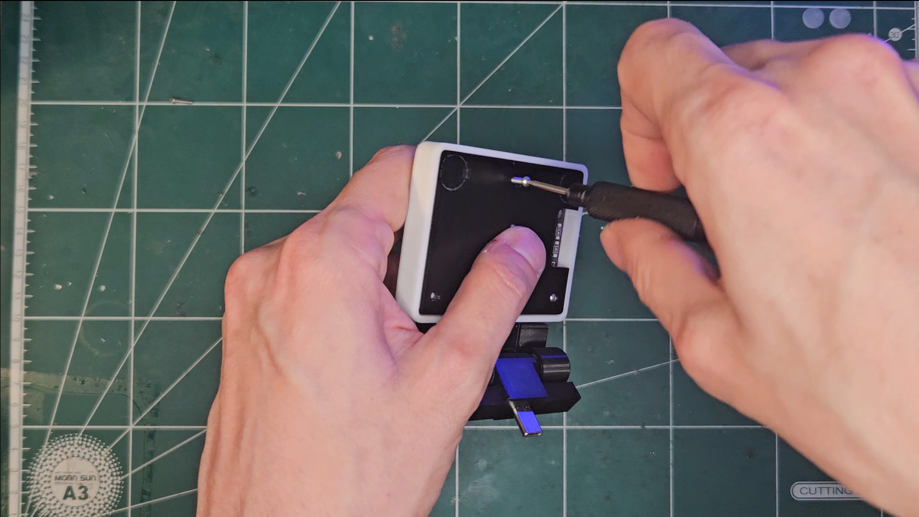
[picture p50: images/assembly/10-back-panel-screws-v2-04.jpg]
Fasten the second M2x8 hex-socket back-plate screw.


Fasten the second M2x8 hex-socket back-plate screw.

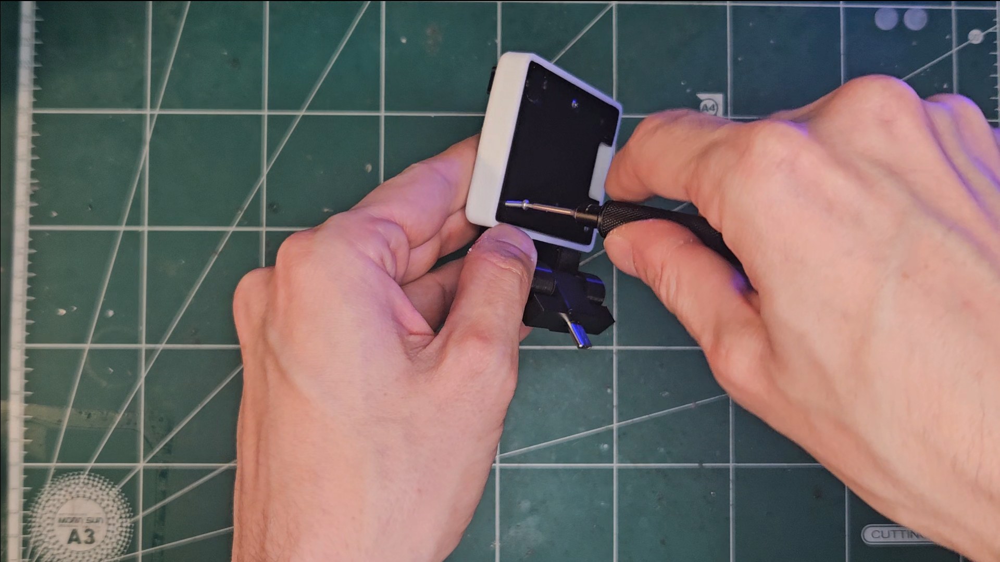
[picture p51: images/assembly/10-back-panel-screws-v2-05.jpg]
Fasten the third M2x8 hex-socket screw while keeping the back plate evenly seated.


Fasten the third M2x8 hex-socket screw while keeping the back plate evenly seated.

CHECK

The back plate is seated evenly, all three M2x8 hex-socket screws are fitted, and the ribbon is clear of the seam.

Back to top ↑

Step 11 / 12

## Stick the silicon feet to the outside of the back plate

Stick the two 10 mm-diameter silicon feet to the back panel's outside at the circular positions shown.

Press each silicon foot down so it adheres fully and its edge is seated.

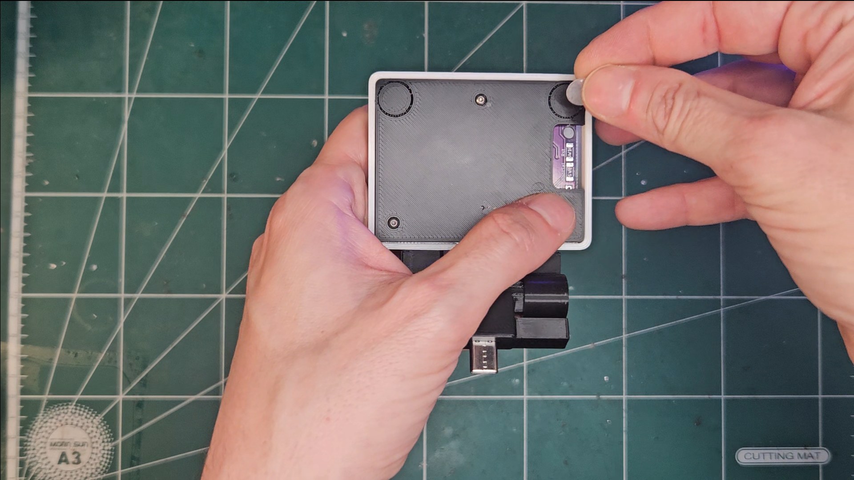
[picture p52: images/assembly/11-felt-click-test-01.jpg]
Stick each 10 mm-diameter silicon foot to the outside of the back plate.


Stick each 10 mm-diameter silicon foot to the outside of the back plate.

CHECK

Both silicon feet stick to the outside of the back plate and remain clear of the seam.

Back to top ↑

Step 12 / 12

## Connect the phone, then perform the final click-test

Align the USB-C male plug on the USB Daughterboard with the phone's USB socket. Support both parts and slide the plug straight into the socket until seated.

Check the completed connection, then perform the final click-test shown in the last photo.

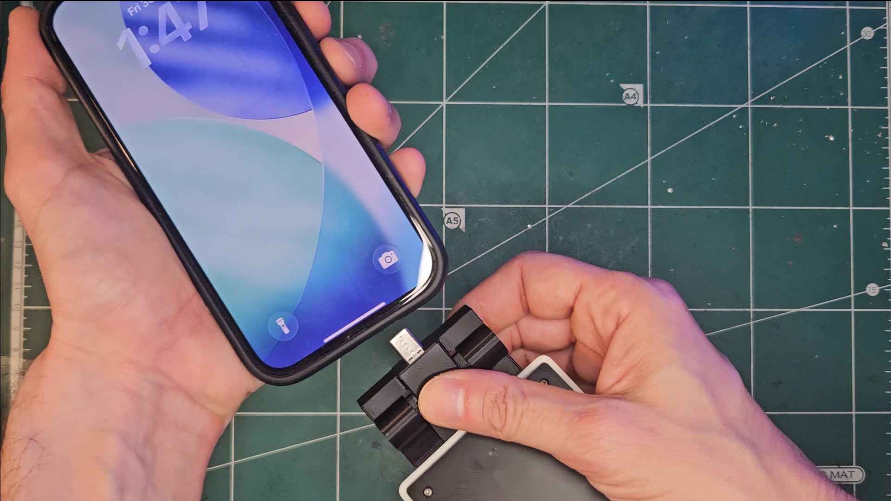
[picture p53: images/assembly/12-phone-usb-01.jpg]
Align the USB-C male plug with the phone's USB socket.


Align the USB-C male plug with the phone's USB socket.

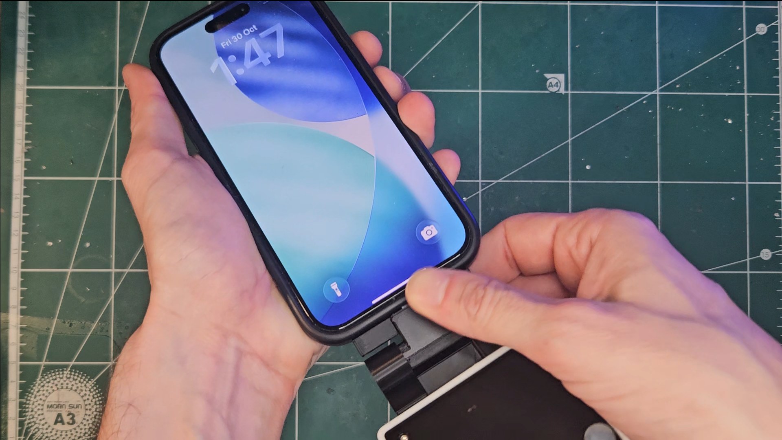
[picture p54: images/assembly/12-phone-usb-02.jpg]
Slide the USB-C male plug straight into the socket until seated.


Slide the USB-C male plug straight into the socket until seated.

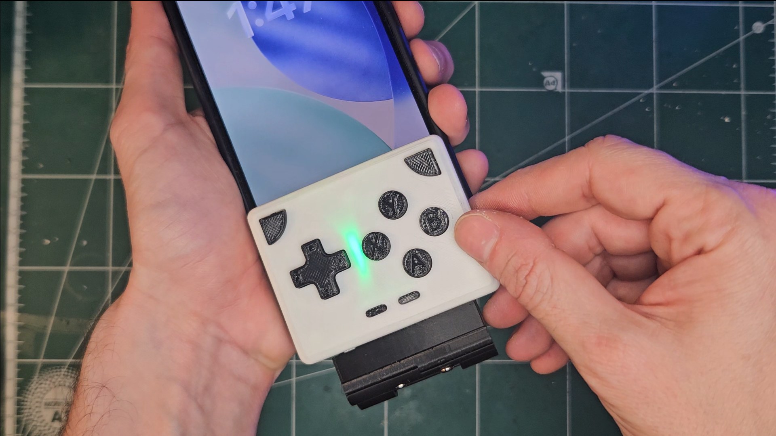
[picture p55: images/assembly/12-phone-usb-03.jpg]
Check the controller is fully connected to the phone.


Check the controller is fully connected to the phone.

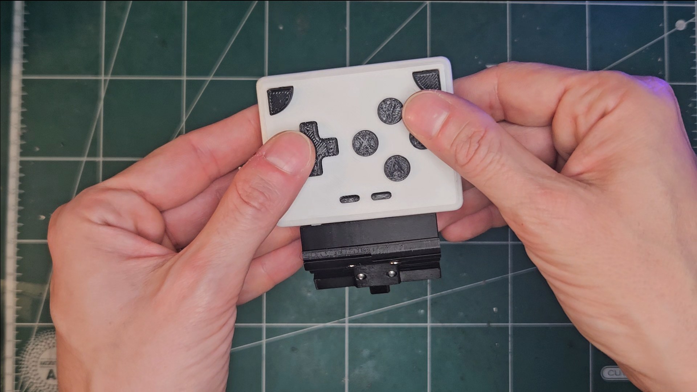
[picture p56: images/assembly/11-felt-click-test-02.jpg]
Final click-test: press each button three times and check that it returns after every click.


Final click-test: press each button three times and check that it returns after every click.

CHECK

Check that all buttons click well and bounce back to the default position after the click. Check three times.

Back to top ↑

✕

Open source hardware

Nothing here is a black box. The firmware, the KiCad schematic and board, and the CAD for every printed part live in the same repository — read them, fork them, cut a version that fits your phone instead of this one.

git clone https://github.com/gili-yankovitch/joyfon

JOYFON

Built by Gili Yankovitch (https://github.com/gili-yankovitch).
