gili-yankovitch/joyfon/images/assembly/06-insert-holes-0305.jpg

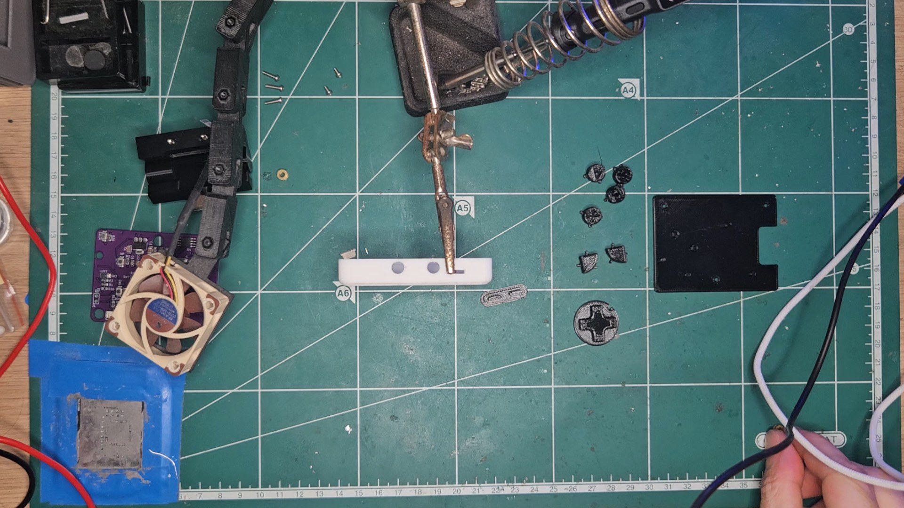
images/assembly/06-insert-holes-0305.jpg
