gili-yankovitch/joyfon/hw/controller/PhoneController.pdf

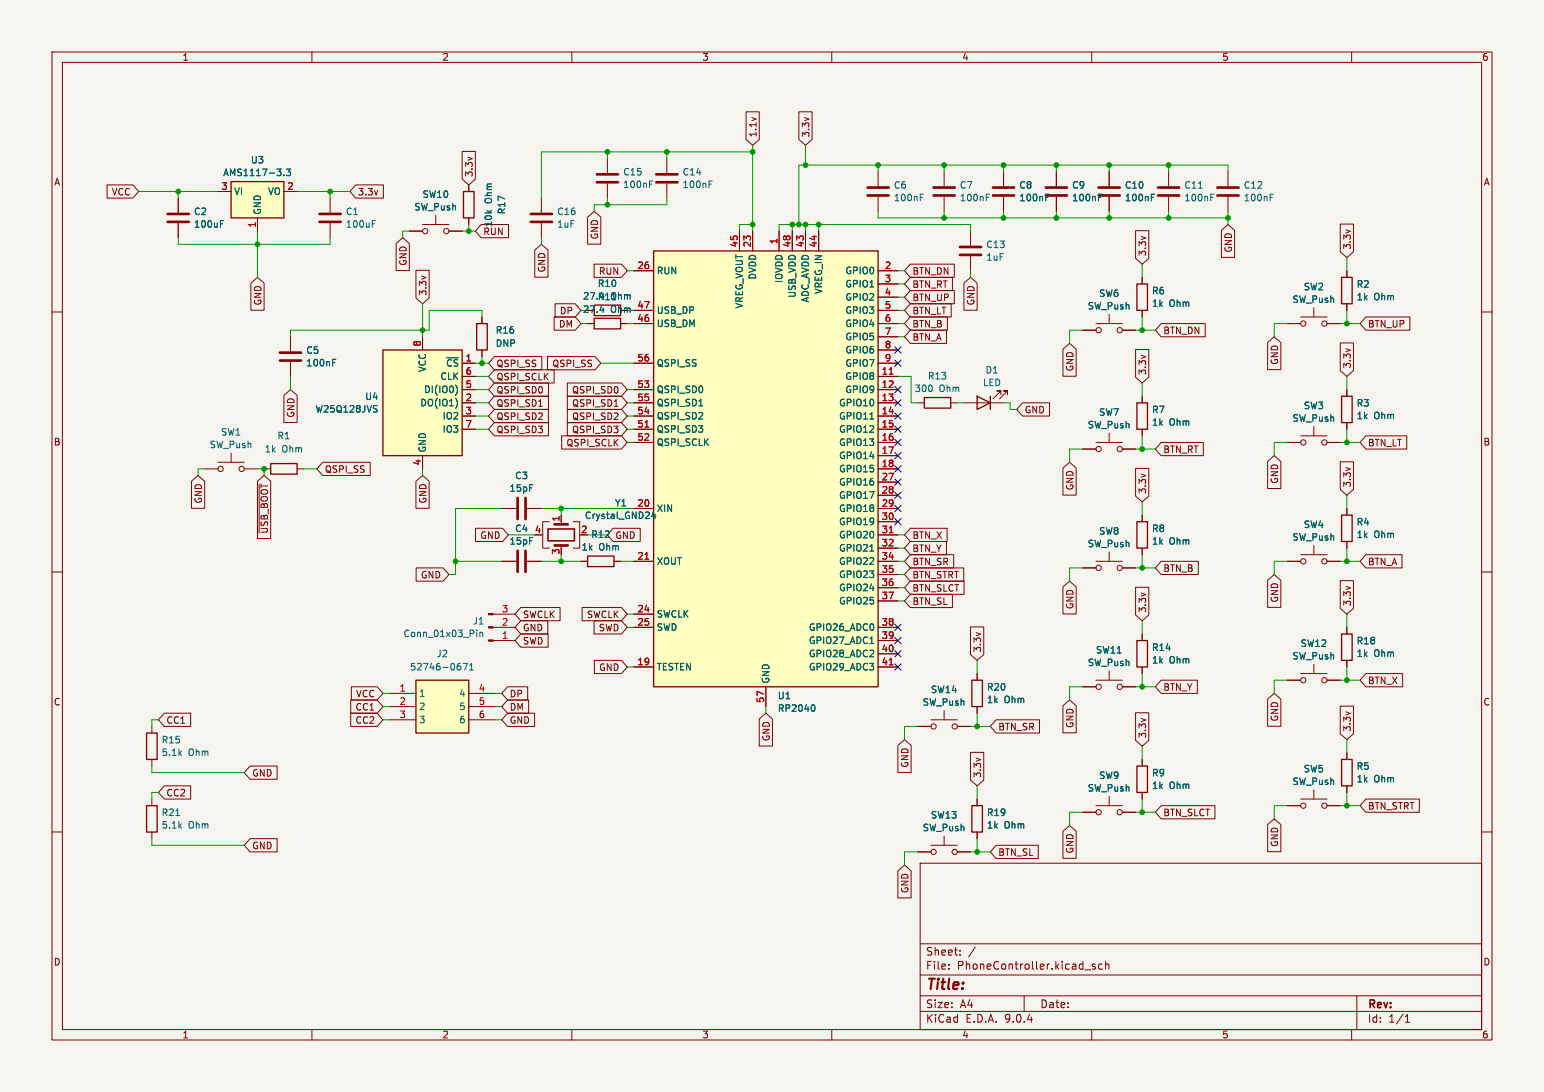
[picture p58: page 1]

Id: 1/1 Title: File: PhoneController.kicad_sch Sheet: /
