gili-yankovitch/joyfon/hw/usb/PhoneControllerUSB.pdf

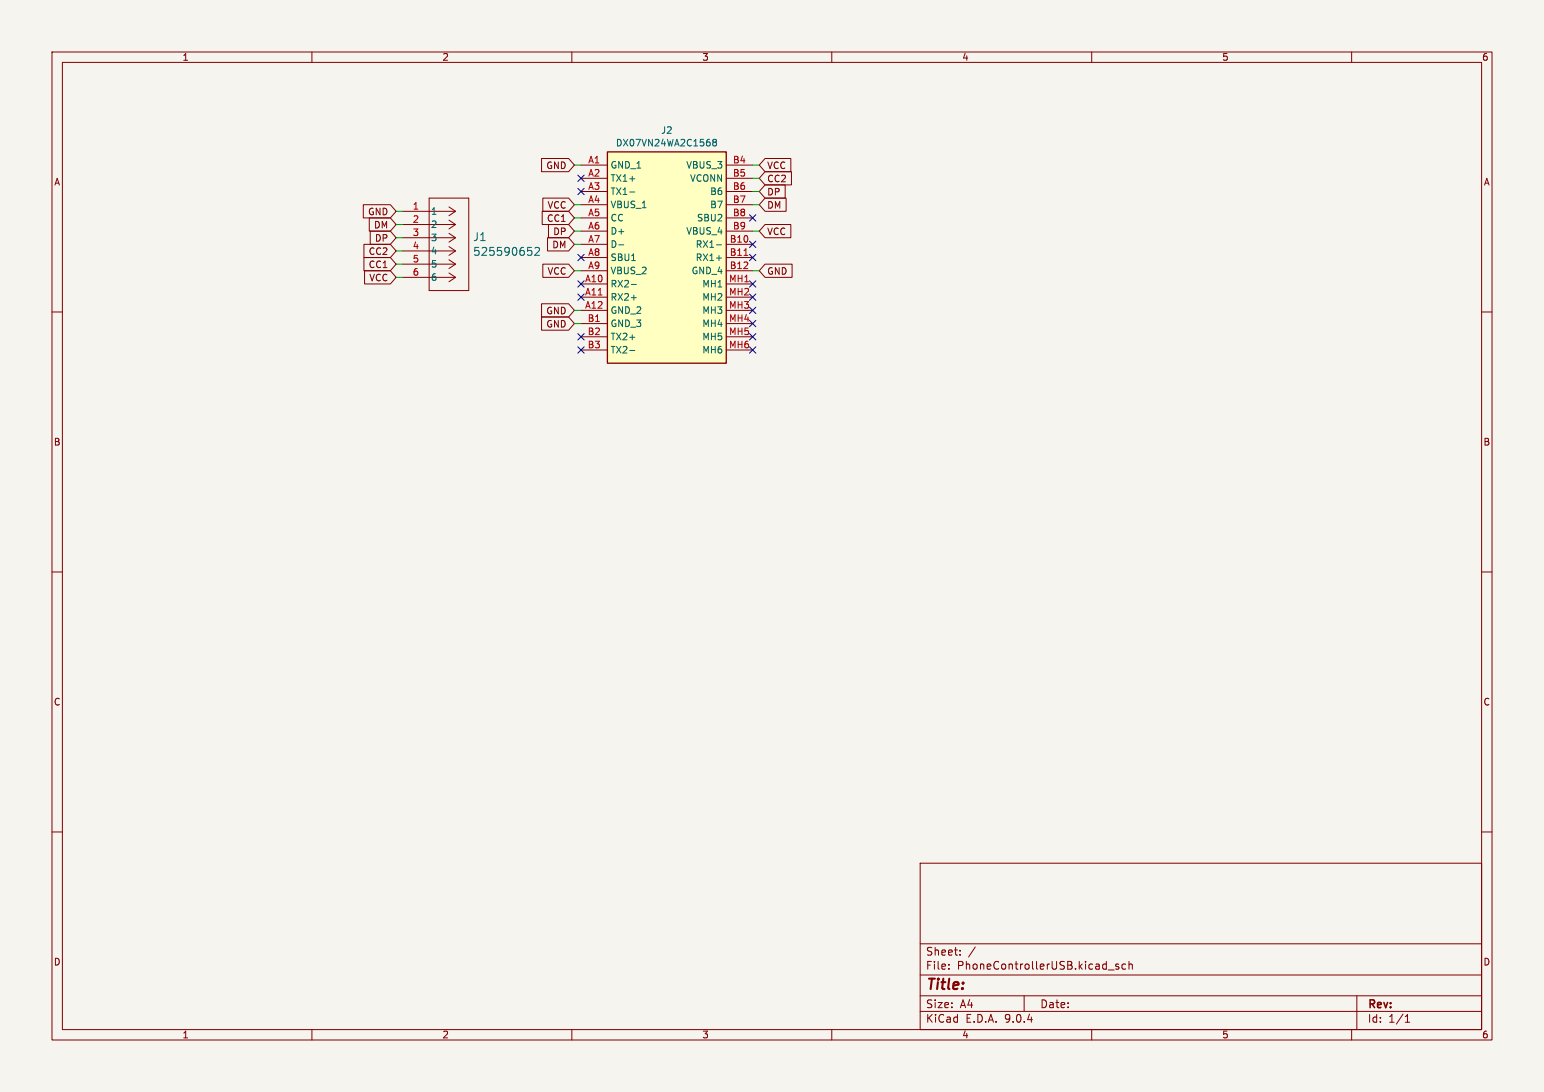
[picture p59: page 1]

Id: 1/1 Title: File: PhoneControllerUSB.kicad_sch Sheet: /
