gili-yankovitch/joyfon/hw/controller/clicky-buttons/PhoneController.kicad_pcb

## KiCad design hw/controller/clicky-buttons/PhoneController.kicad_pcb (2026-11-03)

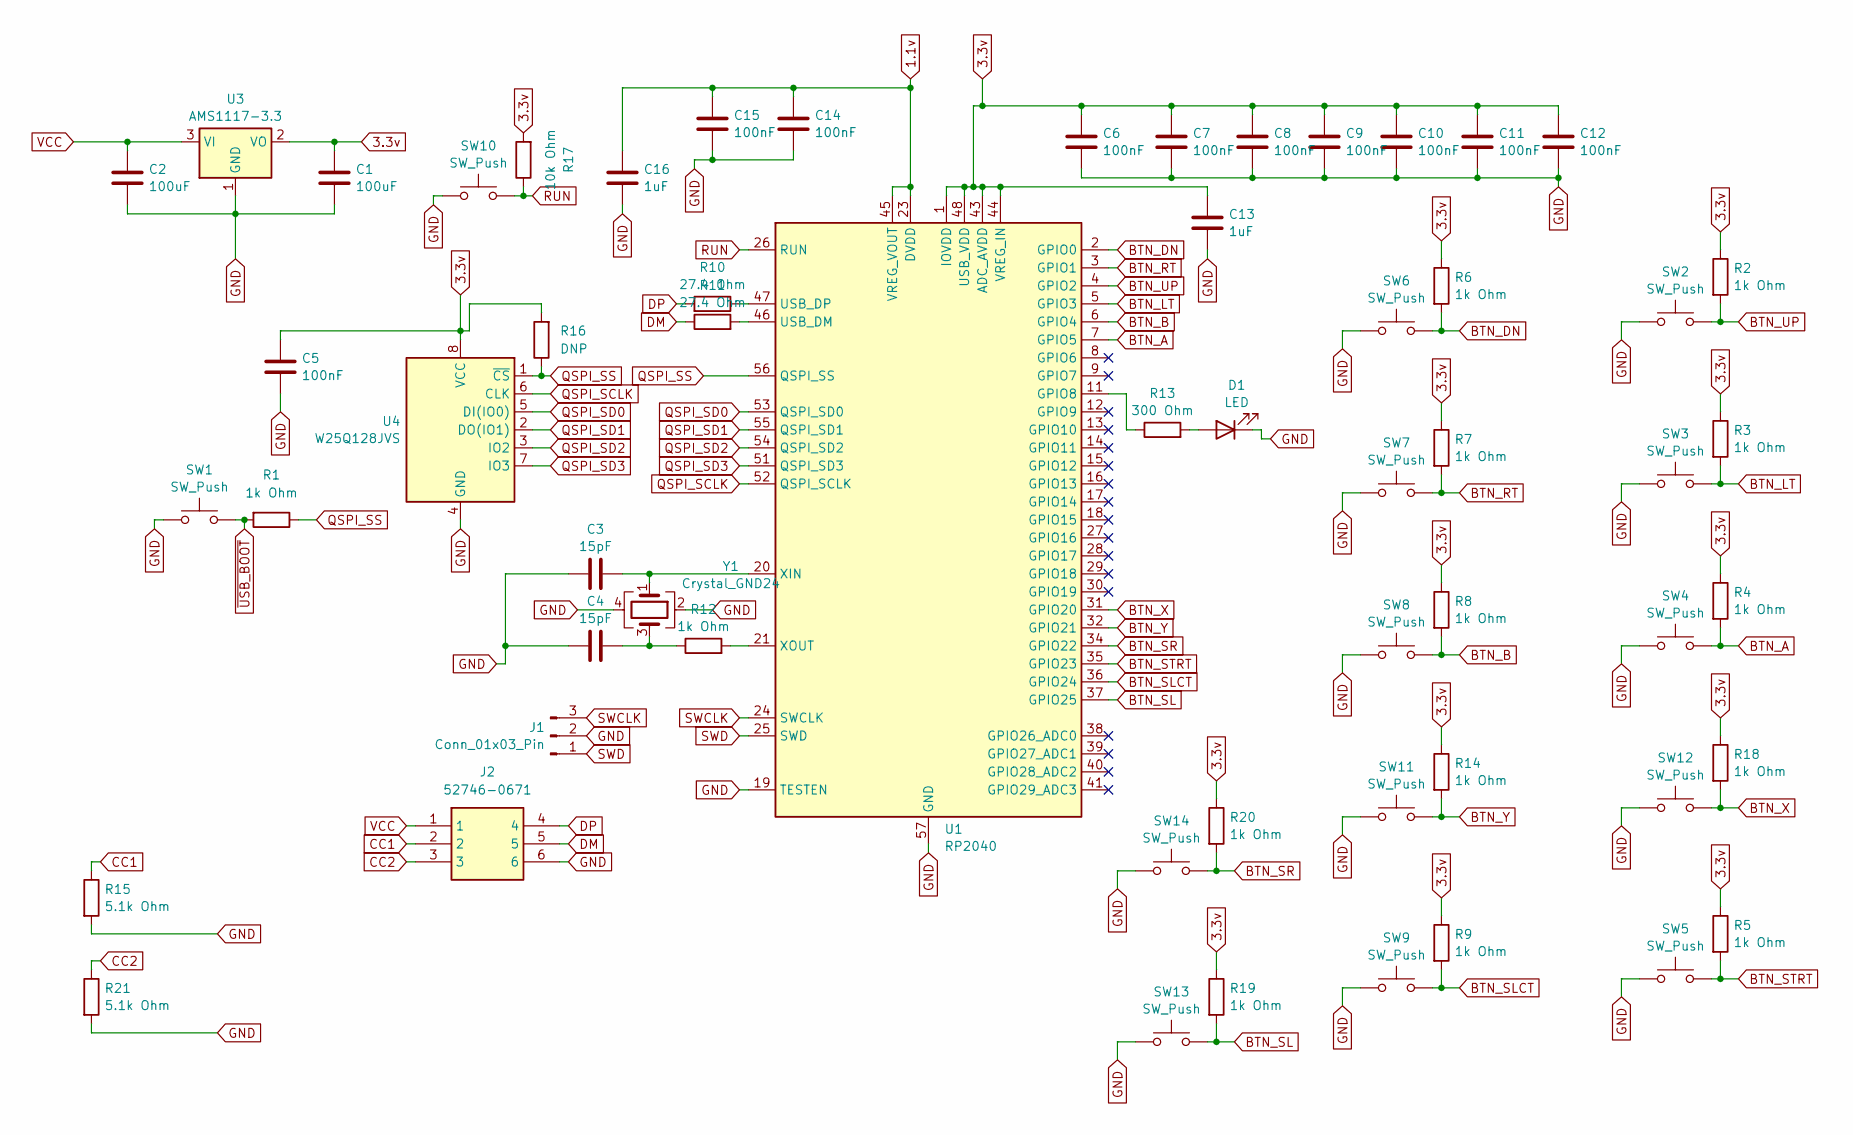
[picture p60: schematic PhoneController.kicad_sch]

Parts:
C1, C2: 100uF; C_1206_3216Metric_Pad1.33x1.80mm_HandSolder
C3, C4: 15pF; C_0805_2012Metric_Pad1.18x1.45mm_HandSolder
C5, C6, C7, C8, C9, C10, C11, C12, C14, C15: 100nF; C_0805_2012Metric_Pad1.18x1.45mm_HandSolder
C13, C16: 1uF; C_0805_2012Metric_Pad1.18x1.45mm_HandSolder
D1: LED; LED_0805_2012Metric_Pad1.15x1.40mm_HandSolder
J1: Conn_01x03_Pin; PinSocket_1x03_P2.54mm_Vertical
J2: 52746-0671; Mouser Part Number 538-52746-0671
R1, R2, R3, R4, R5, R6, R7, R8, R9, R12, R14, R18, R19, R20: 1k Ohm; R_0805_2012Metric_Pad1.20x1.40mm_HandSolder
R10, R11: 27.4 Ohm; R_0805_2012Metric_Pad1.20x1.40mm_HandSolder
R13: 300 Ohm; R_0805_2012Metric_Pad1.20x1.40mm_HandSolder
R15, R21: 5.1k Ohm; R_0805_2012Metric_Pad1.20x1.40mm_HandSolder
R16: DNP; R_0805_2012Metric_Pad1.20x1.40mm_HandSolder
R17: 10k Ohm; R_0805_2012Metric_Pad1.20x1.40mm_HandSolder
SW1, SW2, SW3, SW4, SW5, SW6, SW7, SW8, SW9, SW10, SW11, SW12, SW13, SW14: SW_Push; TS-1088-AR02016
U1: RP2040; QFN-56-1EP_7x7mm_P0.4mm_EP3.2x3.2mm
U3: AMS1117-3.3; SOT-223-3_TabPin2
U4: W25Q128JVS; SOIC127P790X216-8N
Y1: Crystal_GND24; Crystal_SMD_Abracon_ABM8G-4Pin_3.2x2.5mm

Connections:
1.1v: C14.2, C15.2, C16.2, U1.23 (DVDD), U1.45 (VREG_VOUT), U1.50 (DVDD)
3.3v: C1.1, C5.2, C6.2, C7.2, C8.2, C9.2, C10.2, C11.2, C12.2, C13.2, R2.1, R3.1, R4.1, R5.1, R6.1, R7.1, R8.1, R9.1, R14.1, R16.2, R17.2, R18.1, R19.1, R20.1, U1.1 (IOVDD), U1.10 (IOVDD), U1.22 (IOVDD), U1.33 (IOVDD), U1.42 (IOVDD), U1.43 (ADC_AVDD), U1.44 (VREG_IN), U1.48 (USB_VDD), U1.49 (IOVDD), U3.2 (VO), U4.8 (VCC)
BTN_A: R4.2, SW4.2, U1.7 (GPIO5)
BTN_B: R8.2, SW8.2, U1.6 (GPIO4)
BTN_DN: R6.2, SW6.2, U1.2 (GPIO0)
BTN_LT: R3.2, SW3.2, U1.5 (GPIO3)
BTN_RT: R7.2, SW7.2, U1.3 (GPIO1)
BTN_SL: R19.2, SW13.2, U1.37 (GPIO25)
BTN_SLCT: R9.2, SW9.2, U1.36 (GPIO24)
BTN_SR: R20.2, SW14.2, U1.34 (GPIO22)
BTN_STRT: R5.2, SW5.2, U1.35 (GPIO23)
BTN_UP: R2.2, SW2.2, U1.4 (GPIO2)
BTN_X: R18.2, SW12.2, U1.31 (GPIO20)
BTN_Y: R14.2, SW11.2, U1.32 (GPIO21)
CC1: J2.2, R15.1
CC2: J2.3, R21.1
DM: J2.5, R11.1
DP: J2.4, R10.2
GND: C1.2, C2.2, C3.1, C4.1, C5.1, C6.1, C7.1, C8.1, C9.1, C10.1, C11.1, C12.1, C13.1, C14.1, C15.1, C16.1, D1.1 (K), J1.2, J2.6, R15.2, R21.2, SW1.1, SW2.1, SW3.1, SW4.1, SW5.1, SW6.1, SW7.1, SW8.1, SW9.1, SW10.1, SW11.1, SW12.1, SW13.1, SW14.1, U1.19 (TESTEN), U1.57 (GND), U3.1 (GND), U4.4 (GND), Y1.2, Y1.4
unnamed: C4.2, R12.1, Y1.3
unnamed: D1.2 (A), R13.2
unnamed: R13.1, U1.11 (GPIO8)
unnamed: R11.2, U1.46 (USB_DM)
unnamed: R10.1, U1.47 (USB_DP)
unnamed: C3.2, U1.20 (XIN), Y1.1
unnamed: R12.2, U1.21 (XOUT)
QSPI_SCLK: U1.52 (QSPI_SCLK), U4.6 (CLK)
QSPI_SD0: U1.53 (QSPI_SD0), U4.5 (DI(IO0))
QSPI_SD1: U1.55 (QSPI_SD1), U4.2 (DO(IO1))
QSPI_SD2: U1.54 (QSPI_SD2), U4.3 (IO2)
QSPI_SD3: U1.51 (QSPI_SD3), U4.7 (IO3)
QSPI_SS: R1.1, R16.1, U1.56 (QSPI_SS), U4.1 (~CS)
RUN: R17.1, SW10.2, U1.26 (RUN)
SWCLK: J1.3, U1.24 (SWCLK)
SWD: J1.1, U1.25 (SWD)
VCC: C2.1, J2.1, U3.3 (VI)
~USB_BOOT: R1.2, SW1.2

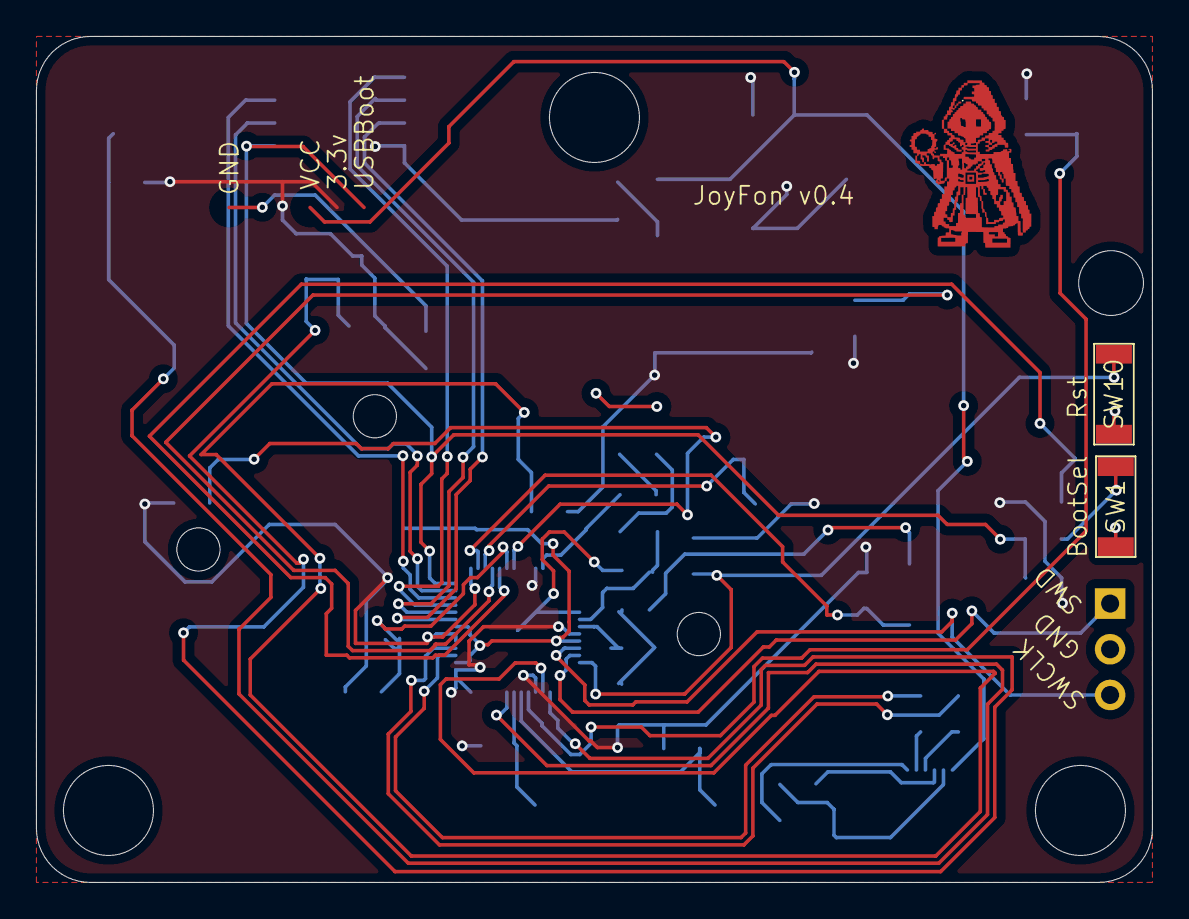
[picture p61: board PhoneController.kicad_pcb from above]

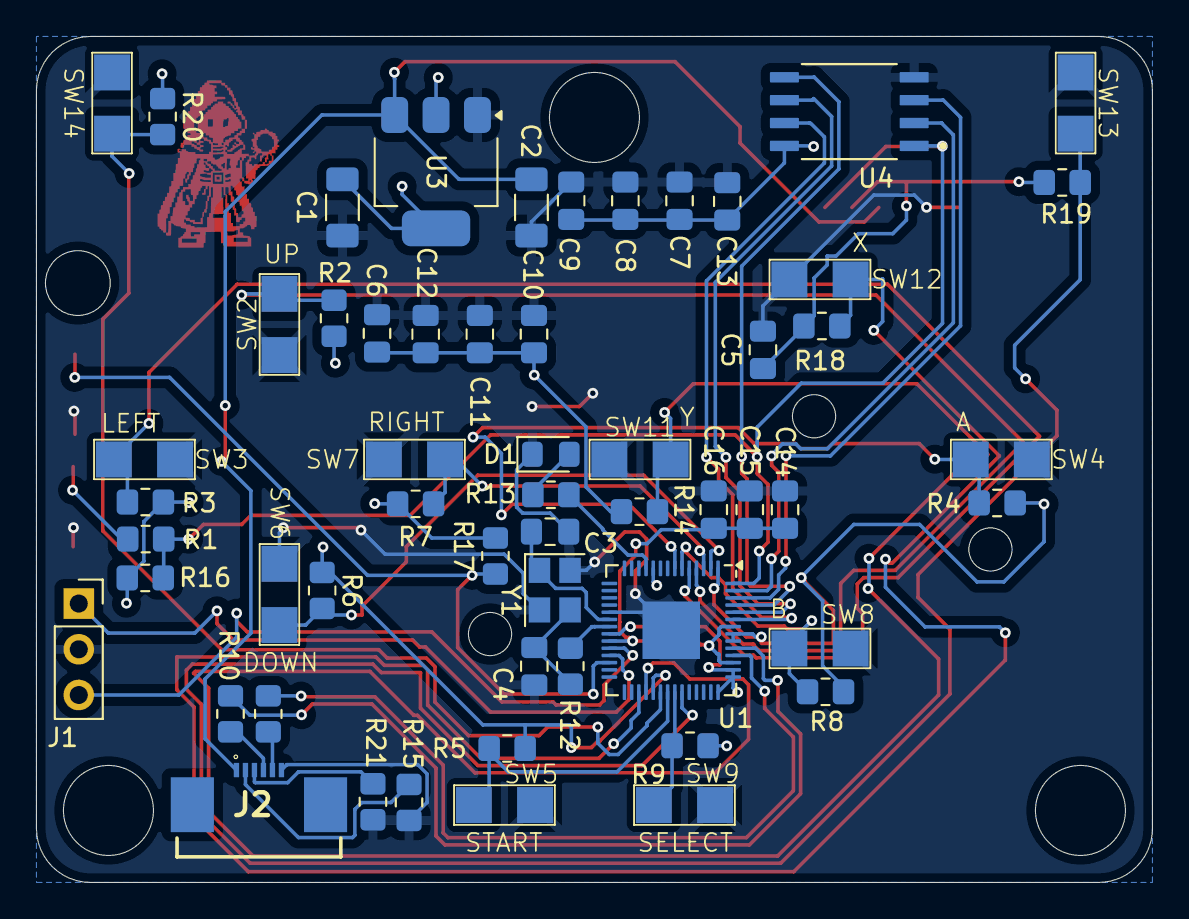
[picture p62: board PhoneController.kicad_pcb from below]

Board: 2 copper layers, 62.0 x 47.0 mm, 58 parts (56 on the bottom side), 37 nets.
