gili-yankovitch/joyfon/(commit log)

2026-07-10 Adding schematics PDF
2026-07-13 chore: Uploading media
    [PhoneControllerCaseV0.3 - BackPlate.stl, PhoneControllerCaseV0.3 - BtnA.stl, PhoneControllerCaseV0.3 - BtnB.stl, PhoneControllerCaseV0.3 - BtnSL.stl, PhoneControllerCaseV0.3 - BtnSR.stl, PhoneControllerCaseV0.3 - BtnX.stl, PhoneControllerCaseV0.3 - BtnY.stl, PhoneControllerCaseV0.3 - ControllerBody.stl]
2026-10-21 chore: Updating schematics
    [PhoneController.kicad_pcb, PhoneController.kicad_sch, PhoneControllerUSB.kicad_pcb, PhoneControllerUSB.kicad_sch]
2026-10-31 Add illustrated assembly guide and refresh production STLs
    [PhoneControllerCaseV0.3 - BackPlate.stl, PhoneControllerCaseV0.3 - BtnA.stl, PhoneControllerCaseV0.3 - BtnB.stl, PhoneControllerCaseV0.3 - BtnSL.stl, PhoneControllerCaseV0.3 - BtnSR.stl, PhoneControllerCaseV0.3 - BtnX.stl, PhoneControllerCaseV0.3 - BtnY.stl, PhoneControllerCaseV0.3 - ControllerBody.stl]
2026-10-31 chore: Fixing weird wording in assembly page
2026-11-01 Use Nintendo face-button names in assembly guide
2026-11-03 chore: Adding the OG version with more clicky buttons
    [PhoneController.kicad_pcb, PhoneController.kicad_sch]
2026-11-03 feat: browser firmware flasher + live controller test, Nintendo button map
    Website:
    - flash.html: WebUSB (PICOBOOT) in-browser flasher + WebHID functionality
    test with a live JoyFon silhouette that lights each button as pressed
    - assets/{picoboot,uf2,flash}.js, flash.css; nav links from index/assembly
    - firmware/joyfon.uf2: published build
    Firmware (src/):
    - Nintendo face layout (A/B and X/Y swapped vs Sony positions)
    - START/SELECT and SL/SR mappings corrected
    - product string renamed to "JoyFon" (VID/PID unchanged, iOS still binds)
    [main.c]
2026-11-03 docs: RP2040 only, drop RP2350 / Pico 2 references
    The JoyFon hardware targets the RP2040 exclusively. Remove the RP2040/RP2350
    tagline wording and the Pico 2 (PICO_BOARD=pico2) build instructions.
2026-11-03 fix(web): mobile Flash link + Gamepad-API controller test
    1. The topbar nav is hidden under 720px, so the Flash link was unreachable on
    mobile. Add an always-visible "⚡ Flash" pill to the topbar (index/assembly).
    2. The functionality test used WebHID, which no mobile browser supports. Rewrite
    it on the Gamepad API (works on desktop, Android Chrome and iOS Safari): poll
    the standard-mapping gamepad and translate its button indices back to the
    physical JoyFon buttons. No permission prompt; auto-connects on first press.
2026-11-03 fix(web): correct SL/SR and START/SELECT in the gamepad test
    The Gamepad API reports the device by its standard-mapping index. Map the
    silhouette by how each physical button actually plays on the phone (verified
    on-device): SL=L1(4), SR=R1(5), SELECT=view(8), START=menu(9). Previously these
    two pairs read reversed.
2026-11-07 Show two brass threaded inserts in assembly inventory
